lokeralexander-code/DAP_PCB/README.md

# DAP_PCB
The goal of this project is to create a digital audio player from scratch including a custom PCB, Mechanical Shell, and Software.

# PCB Progress:

The schematic is complete. Moving onto the layout and routing.
