lokeralexander-code/DAP_PCB/Electrical/Documentation/Power/LT3042 - +3V3 LDO/DAP_LT3042_Rev8.pdf

# Positive LDO (LT3042): Working Document

### Digital Audio Player • Rev 8

Author: Alexander Loker. Design decisions, component selection, analysis and verification. Drafted by: Claude (Anthropic). Structure and prose from the author’s direction and source data.

Contents

1 Summary | 1
2 Design Requirements | 1
3 Pin Configuration | 1
4 External Components | 2
5 Equations and Results | 2
6 Important Values | 3
7 Open Problems | 4
8 Revision Log | 4
9 Sources | 4

### 1. Summary

Field | Value
Manufacturer / MPN | Analog Devices, LT3042EDD#TRPBF
Package | 10-lead DFN, 3 × 3 mm, exposed pad (pin 11) = GND
Function | Ultralow-noise positive LDO, +3V9 → +3.3 V analog rail

### 2. Design Requirements

Requirement | Value
Input | +3V9 from LTC3440, 3.827 to 3.981 V; 7.7 mV pp ripple; ±90 mV load step (minimum 3.74 V)
Output | 3.32 V
Load | I/V, summing, OPA1622 (V+ side), DAC analog supplies
Maximum audio output | 0.6 V RMS (EW300: 119 dB/V worst nozzle, 28 Ω ±15%)
Output current | ≈ 35 mA quiescent (OPA1612 21.6 mA, OPA1622 5.2 mA, DAC analog 8 mA); ≈ 106 mA peak (200 mA rated)
Current limit | 125 mA programmed (RILIM)
UVLO | 3.5 V rising
Power good | ≈ 91% of VOUT, to MCU GPIO
Constraints | Low noise · Small footprint

### 3. Pin Configuration

Positive LDO (LT3042) · Rev 8 | Page 1 of 4

Pin | Name | Connection
1, 2 | IN | +3V9, CIN
3 | EN/UV | REN2 from IN, REN1 to GND
4 | PG | RPU to +3V3, MCU GPIO
5 | ILIM | RILIM to GND (Kelvin to pin 8)
6 | PGFB | RPG2 / RPG1 midpoint
7 | SET | RSET ∥ CSET to GND; CSET anode to SET
8 | GND | GND
9 | OUTS | OUT at the load
10 | OUT | +3V3A, COUT, RPG2
11 | Exposed pad | GND

### 4. External Components

Ref | Value / Rating | MPN | AL-PN
RSET | 33.2 kΩ 0.1% 0402 | YAGEO RT0402BRD0733K2L | #1-085
CSET | 2.2 µF ±20% tantalum, 16 V, 0603, polarized (no DC-bias derating, not piezoelectric) | Vishay 298D225X0016M2T | #1-098
CIN | 10 µF 10 V X7R 0805 (6.76 µF effective at 3.9 V) | Murata GCM21BR71A106KE22K | #1-081
COUT | 10 µF 10 V X7R 0805 (7.56 µF effective at 3.3 V) | Murata GCM21BR71A106KE22K | #1-081
REN1 | 50 kΩ 0.1% 0603 | YAGEO RT0603BRD0750KL | #1-075
REN2 | 90.9 kΩ 0.1% 0402 | YAGEO RT0402BRD0790K9L | #1-084
RPG1 | 100 kΩ 0.1% 0603 | YAGEO RT0603BRD07100KL | #1-066
RPG2 | 909 kΩ 1% 0402 | YAGEO RC0402FR-07909KL | #1-083
RILIM | 1.0 kΩ 0.1% 0402 | YAGEO RT0402BRD071KL
RPU | 10 kΩ 0603 | Generic

### 5. Equations and Results

Output voltage

VOUT = ISET RSET = 100 μA × 33.2 kΩ = 3.32 V

Source: LT3042 Datasheet (Analog Devices), (https://wcm-cce.cldnet.analog.com/media/en/technical-documentation/data-sheets/lt3042.pdf) SET pin. Undervoltage lockout (IEN term neglected)

VIN(UVLO) = 1.24 (1 + REN2

REN1 ) = 1.24 (1 + 90.9
50 ) = 3.494 V

Source: LT3042 Datasheet (Analog Devices), (https://wcm-cce.cldnet.analog.com/media/en/technical-documentation/data-sheets/lt3042.pdf) EN/UV pin.

Power-good threshold (IPGFB term neglected)

VOUT(PG) = 0.3 (1 + RPG2

RPG1 ) = 0.3 (1 + 909
100) = 3.027 V (91.2%)

Source: LT3042 Datasheet (Analog Devices), (https://wcm-cce.cldnet.analog.com/media/en/technical-documentation/data-sheets/lt3042.pdf) PGFB pin.
Current limit (ILIM threshold 300 mV; 125 mA·kΩ scale factor)

ILIM =

125 mA⋅kΩ

RILIM

=

125 mA⋅kΩ
1.0 kΩ = 125 mA (1.18 × the 106 mA peak)

Source: LT3042 Datasheet (Analog Devices), (https://wcm-cce.cldnet.analog.com/media/en/technical-documentation/data-sheets/lt3042.pdf) ILIM pin. SET noise-filter corner (1 µF effective)

fc =

1
2πRSETCSET

=

1
2π ⋅ 33.2 kΩ ⋅ 1 μF

= 4.8 Hz

Soft-start (fast start-up to ≈ 2.7 V, then the RSETCSET tail; 1 µF effective)

τ = RSETCSET = 33.2 ms, | t99 = τ ln 0.62
| 0.033

= 2.93 τ ≈ 97 ms/μF

Source: LT3042 Datasheet (Analog Devices), (https://wcm-cce.cldnet.analog.com/media/en/technical-documentation/data-sheets/lt3042.pdf) fast start-up. Headroom and maximum SPL

VIN(MIN) − VOUT = 3.74 − 3.32 = 0.42 V
SPLMAX = 119 + 20 log10(0.6) = 114.6 dB (116.6 dB steel nozzle)

CSET sweep (simulated; LTC3440 replaced by an ideal 3.9 V source; 29 Ω load):

CSET (effective) | t99 | Noise, 20 Hz to 20 kHz
0.47 µF | 46 ms | 1.16 µV RMS
1 µF | 98 ms | 0.63 µV RMS
2.2 µF | 214 ms | 0.40 µV RMS
4.7 µF | 455 ms | 0.34 µV RMS

Load current (0.6 V RMS = 0.85 V peak design maximum, both channels in phase):

Case | Per channel pk | Signal total | + Quiescent | Regulator pk
Full scale, 23.8 Ω (28 Ω −15%) | 35.7 mA | 71.3 mA | 35 mA | ≈ 106 mA
Full scale, 28 Ω nominal | 30.3 mA | 60.6 mA | 35 mA | ≈ 96 mA
110 dB SPL peak (0.35 V RMS), 23.8 Ω | 21.1 mA | 42.2 mA | 35 mA | ≈ 77 mA

### 6. Important Values

Item | Value
SET pin current | 100 µA
EN/UV rising threshold | 1.24 V
PGFB threshold | 300 mV
Dropout | 350 mV typ at 200 mA
Rated output current | 200 mA
Current limit | 125 mA programmed; ILIM also monitors output current (1:400, 0 to 300 mV)
Peak load | ≈ 106 mA at 0.6 V RMS maximum (53% of rating)
Minimum headroom | 0.42 V
UVLO / PG divider current | ≈ 28 µA from +3V9 / ≈ 3.3 µA from OUT
Output settled (99%) | ≈ 214 ms after enable (2.2 µF, simulated)
Output noise | 0.40 µV RMS, 20 Hz to 20 kHz (2.2 µF, simulated)
CSET leakage | 0.5 µA max at 16 V rating (≤ 0.5% output error); far lower at 3.3 V
Firmware delay | Wait ≈ 214 ms after enable before enabling the OPA1622
PG in shutdown | High impedance: reads good while EN/UV is low (simulated)

### 7. Open Problems

None.

### 8. Revision Log

Rev | Date | Change
0 | 2026-09-21 | Initial issue: RSET, UVLO, PG, soft-start, load current.
1 | 2026-09-22 | CSET 2.2 µF nominal; start-up and noise sweeps.
2 | 2026-09-22 | CIN / COUT 10 µF GCM21BR71A106KE22K.
3 | 2026-09-22 | Library parts assigned; RPG2 to 1%.
4 | 2026-09-22 | Maximum output 0.6 V RMS; peak load 98 mA.
5 | 2026-09-22 | Current limit 125 mA: RILIM 1.0 kΩ.
6 | 2026-09-23 | CSET 2.2 µF tantalum 298D225X0016M2T, anode to SET.
7 | 2026-09-25 | Reformatted; linked contents and sources; open problems closed.
8 | 2026-09-27 | Load updated from Power Budget Rev 6: quiescent ≈ 35 mA, peak ≈ 106 mA (current limit 1.18× the peak).

### 9. Sources

1. LT3042 Datasheet (Analog Devices) (https://wcm-cce.cldnet.analog.com/media/en/technical-documentation/data-sheets/lt3042.pdf)
