lokeralexander-code/DAP_PCB/Electrical/Documentation/Audio/OPA1612 - Summing Stage/DAP_Summing_Stage_OPA1612_Rev5.pdf

# Differential Summing Stage (OPA1612): Working Document

### Digital Audio Player • Rev 5

Author: Alexander Loker. Design decisions, component selection, analysis and verification.
Drafted by: Claude (Anthropic). Structure and prose from the author’s direction and source data.

Contents

1 Summary | 1
2 Design Requirements | 1
3 Pin Configuration | 2
4 External Components | 2
5 Equations and Results | 2
6 Open Problems | 3
7 Revision Log | 3
8 Sources | 4

### 1. Summary

Field | Value
Manufacturer / MPN | Texas Instruments, OPA1612AIDRGR (AL-PN #1-104)
Package | 8-SON, 3 × 3 mm, dual op-amp; one package covers both channels
Function | Differential summing with a second-order multiple-feedback (MFB) Butterworth low-pass
Signal chain | I/V (×2 per channel) → differential summing and MFB low-pass → OPA1622 output stage → 3.5 mm jack

Each channel’s two I/V outputs are subtracted into one single-ended signal, scaled to the headphone level, and low-pass filtered, all in one op-amp. MFB was chosen over Sallen-Key because it can attenuate (gain below 1), subtracts in the same stage, keeps rolling off into the MHz region where Sallen-Key feedthrough limits rejection to roughly 40 to 60 dB, and holds its inputs at a virtual ground, so there is no common-mode input swing on ±3.3 V rails. A Butterworth response gives the flattest passband with no ripple.

### 2. Design Requirements

Requirement | Value
Gain | 0.44: 0.85 V peak (0.6 V RMS) headphone target ÷ 1.93 V peak nominal differential input. The OPA1622 stage is unity gain.
Response | Butterworth, Q = 0.7071, passband ripple 0 dB
Corner frequency | f0 = 70 kHz (minimum 60.96 kHz for ≤ 0.05 dB loss at 20 kHz; margin for tolerance)
Passband loss | Chain total ≤ 0.1 dB at 20 kHz (I/V + summing)
Supply | ±3.3 V analog rails
Differential Summing Stage (OPA1612) · Rev 5 | Page 1 of 4

Requirement | Value
Constraints | Low noise (resistors in the hundreds of Ω) · Small footprint · C0G capacitors in the signal path

### 3. Pin Configuration

Channel A is left and channel B is right. Component labels follow the TI cookbook: R3 input, R1 feedback, R2 middle, C1 node-to-ground, C2 feedback.

Pin | Name | Connection
1 | OUT A | SUMM_L; R1 (220 Ω) back to node XL ; C2 (2.7 nF) back to −IN A
2 | −IN A | From IV_L via R3 (499 Ω) → node XL (C1 13 nF to GND) → R2 (681 Ω)
3 | +IN A | From IV_LB via the mirrored network: R3, node (C1 and R1 to GND), R2; C2 from +IN A to GND
4 | V− | −3V3, 0.1 µF X7R to GND
5 | +IN B | From IV_RB via the mirrored network
6 | −IN B | From IV_R via R3 → node XR (C1 to GND) → R2
7 | OUT B | SUMM_R; R1 back to node XR ; C2 back to −IN B
8 | V+ | +3V3_ANALOG, 0.1 µF X7R to GND

Polarity: the I/V stage inverts (IV_L = −k·s, IV_LB = +k·s), so the output is G × (k·s − (−k·s)) = +2Gk·s, in phase with the audio. This assumes DACL and DACR are the true-phase DAC outputs.

### 4. External Components

Ref | Value | Part / Notes | Qty | AL-PN
U | Dual op-amp | TI OPA1612AIDRGR, 8-SON | 1 | #1-104
R3 | 499 Ω, 0.1%, 0402 | YAGEO RT0402BRD07499RL, thin film. Same part as I/V Rf . | 4 | #1-105
R1 | 220 Ω, 0.1%, 0402 | YAGEO RT0402BRD07220RL, thin film. Feedback and mirrored ground leg. | 4 | #1-109
R2 | 681 Ω, 0.1%, 0402 | YAGEO RT0402BRD07681RL, thin film | 4 | #1-110
C1 | 13 nF, 50 V, C0G, 5%, 0805 | Murata GRM2195C1H133JA01D. One per X node; also filters common-mode. | 4 | #1-108
C2 | 2.7 nF, 50 V, C0G, 2%, 0402 | Murata GRM1555C1H272GE01D. Feedback and mirrored ground leg. | 4 | #1-107
Cdec | 0.1 µF X7R, 0402 | One per supply pin | 2

### 5. Equations and Results

Transfer function (TI labels)

H(s) =

1
R2R3C1C2

s

2 + s

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
) + 1 R1R2C1C2

Source: Analog Engineer’s Circuit Cookbook: Amplifiers, MFB Low-Pass Filter (Texas Instruments). (https://www.ti.com/seclit/eb/slyy137d/slyy137d.pdf)

Design equations (matching the denominator to s

2 + (ω0/Q) s + ω²
0

)

G = R1
R3

=

220
499 = 0.441

C1 =

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
) = 12.89 nF

C2 =

1
ω

2
0 R1R2C1

= 2.68 nF (ω0 = 2π ⋅ 70 kHz, Q = 0.7071, R2 = 681 Ω)

Source: Analog Engineer’s Circuit Cookbook: Amplifiers, MFB Low-Pass Filter (Texas Instruments); (https://www.ti.com/seclit/eb/slyy137d/slyy137d.pdf) derived from the transfer function above.

Passband loss (general second-order form, x = f/f0
)

|H|⁻² = (1 − x²
)

2

+ ( x
Q

)

2
, | Loss = 10 log10 |H|⁻²
Source: standard second-order low-pass magnitude; reduces to 1 + x⁴ | at Q = 0.7071.
Quantity (standard values 13 nF, 2.7 nF) | Value
f0 / Q | 69.4 kHz / 0.707
Summing-stage loss at 20 kHz | 0.030 dB
Chain loss at 20 kHz (with I/V 0.038 dB) | 0.068 dB
Attenuation at 1 MHz: summing stage / whole chain | ≈ 46 dB / ≈ 60 dB
Input: I/V peak per leg, nominal / worst | 0.96 V / 1.08 V
Input: differential peak, nominal / worst | 1.93 V / 2.17 V

### 5.1 Simulation

AC sweep of one channel with the TI OPA1612 model on ±3.3 V; differential drive of 0.5 V AC on each input, 180° apart; 10 Hz to 10 MHz, 100 points/decade. The I/V stage is not included.

Quantity | Simulated | Hand calculation
Passband gain | −7.1 dB | −7.1 dB (0.441)
−3 dB frequency | 69.30 kHz | 69.4 kHz
Passband shape | Flat through 20 kHz, no peaking | Q = 0.707
Stopband slope | 40 dB/decade | 40 dB/decade
Level at 1 MHz | −53 dB (46 dB below passband) | 46 dB below passband
High-frequency floor | Flattens near −84 dB at 5 to 10 MHz (op-amp gain-bandwidth limit) | Not modelled

### 6. Open Problems

None.

### 7. Revision Log

Rev | Date | Change
0 | 2026-09-24 | Initial issue: topology, requirements, component values, equations.
1 | 2026-09-24 | Standard values: R2 = 681 Ω, C1 = 13 nF, C2 = 2.7 nF.
2 | 2026-09-24 | AC-sweep simulation added.
3 | 2026-09-24 | Part numbers added; all resistors 0.1% thin film.
4 | 2026-09-24 | Leg assignment and output polarity recorded.
5 | 2026-09-25 | Reformatted; op-amp in title; requirements and constraints merged; equations typeset.

### 8. Sources

1. Analog Engineer’s Circuit Cookbook: Amplifiers, MFB Low-Pass Filter (Texas Instruments) (https://www.ti.com/seclit/eb/slyy137d/slyy137d.pdf)
2. OPA1612 Product Page and Datasheet (Texas Instruments) (https://www.ti.com/product/OPA1612)
3. ES9038Q2M Datasheet v1.4 (ESS Technology) (https://www.mouser.sk/datasheet/2/1082/ES9038Q2M_Datasheet_v1_4-3074379.pdf)
