lokeralexander-code/DAP_PCB/Electrical/Documentation/Power/LT3042 - +3V3 LDO/DAP_LT3093_Rev9.pdf

# Negative LDO (LT3093): Working Document

### Digital Audio Player • Rev 9

Author: Alexander Loker. Design decisions, component selection, analysis and verification. Drafted by: Claude (Anthropic). Structure and prose from the author’s direction and source data.

Contents

1 Summary | 1
2 Design Requirements | 1
3 Pin Configuration | 1
4 External Components | 2
5 Equations and Results | 2
6 Important Values | 4
7 Open Problems | 4
8 Revision Log | 4
9 Sources | 5

### 1. Summary

Field | Value
Manufacturer / MPN | Analog Devices, LT3093EDD#TRPBF
Package | 12-lead DFN, 3 × 3 mm, exposed pad (pin 13) = IN
Function | Ultralow-noise negative LDO, −3V9 → −3.3 V analog rail

### 2. Design Requirements

Requirement | Value
Input | −3V9 from the LT3462A inverter (regulated), −3.816 to −3.971 V
Output | −3.32 V
Load | I/V, summing, OPA1622 (V− side)
Maximum audio output | 0.6 V RMS (EW300: 119 dB/V worst nozzle, 28 Ω ±15%)
Output current | ≈ 27 mA quiescent; ≈ 98 mA peak (200 mA rated)
Current limit | 125 mA programmed (RILIM)
UVLO | −3.5 V rising
Power good | −3.0 V (90.4% of VOUT), to MCU GPIO
VIOC | Unused, floated
Constraints | Low noise · Small footprint

### 3. Pin Configuration

Negative LDO (LT3093) · Rev 9 | Page 1 of 5

Pin | Name | Connection
1, 2 | IN | −3V9, CIN
3 | EN/UV | REN2 from IN, REN1 to GND
4 | PG | RPU to +3V3, MCU GPIO
5 | PGFB | RPG1 / RPG2 midpoint
6 | ILIM | RILIM to GND (Kelvin to pin 9)
7 | VIOC | Not connected (float)
8 | SET | RSET ∥ CSET to GND; CSET cathode to SET (SET is at −3.32 V)
9 | GND | GND
10 | OUTS | OUT at the load
11, 12 | OUT | −3V3A, COUT, RPG1
13 | Exposed pad | IN (−3V9): own pour and via field, never GND

### 4. External Components

Ref | Value / Rating | MPN | AL-PN
RSET | 33.2 kΩ 0.1% 0402 | YAGEO RT0402BRD0733K2L | #1-085
CSET | 2.2 µF ±20% tantalum, 16 V, 0603, polarized; anode to GND | Vishay 298D225X0016M2T | #1-098
CIN | 10 µF 10 V X7R 0805 (6.76 µF effective at 3.9 V) | Murata GCM21BR71A106KE22K | #1-081
COUT | 10 µF 10 V X7R 0805 (7.56 µF effective at 3.3 V) | Murata GCM21BR71A106KE22K | #1-081
REN1 | 50 kΩ 0.1% 0603 | YAGEO RT0603BRD0750KL | #1-075
REN2 | 88.7 kΩ 0.1% 0402 | YAGEO RT0402BRD0788K7L
RPG1 | 135 kΩ 0.1% 0402 (E192) | YAGEO RT0402BRD07135KL
RPG2 | 15 kΩ 0.1% 0402 | YAGEO RT0402BRD0715KL | #1-078
RILIM | 15.6 kΩ 0.1% 0402 (E192) | YAGEO RT0402BRD0715K6L
RPU | 10 kΩ 0603 | Generic

### 5. Equations and Results

Output voltage (range over ISET = 98 to 102 µA)

VOUT = −ISET RSET = −100 μA × 33.2 kΩ = −3.32 V (−3.254 to − 3.386 V)

Source: LT3093 Datasheet (Analog Devices), (https://www.analog.com/media/en/technical-documentation/data-sheets/lt3093.pdf) SET pin.

Undervoltage lockout (IEN negligible for REN1 < 100 kΩ)

REN2 = REN1 (

3.5
1.26 − 1) = 88.89 kΩ → 88.7 kΩ

VIN(UVLO) = −1.26 (1 + 88.7
50 ) = −3.495 V (−3.33 to − 3.69 V)

VIN(UVLO,falling) = −(1.26 − 0.215) (1 + 88.7 50 ) = −2.90 V (sim ≈ −3.0 V)

Source: LT3093 Datasheet (Analog Devices), (https://www.analog.com/media/en/technical-documentation/data-sheets/lt3093.pdf) EN/UV pin. Power-good threshold (RPG1 is the top resistor)

RPG1 = RPG2 (

3.0

0.3 − 1) = 135 kΩ, VOUT(PG) = −0.3 (1 + 135 15 ) = −3.000 V (90.4%)

Source: LT3093 Datasheet (Analog Devices), (https://www.analog.com/media/en/technical-documentation/data-sheets/lt3093.pdf) PGFB pin.
Current limit (ILIM regulates to −300 mV; 1.95 kΩ·A scale factor)

ILIM =

1.95 kΩ⋅A

RILIM

=

1.95 kΩ⋅A
15.6 kΩ = 125 mA

Source: LT3093 Datasheet (Analog Devices), (https://www.analog.com/media/en/technical-documentation/data-sheets/lt3093.pdf) ILIM pin. Soft-start (fast start-up to −3.0 V, then the RSETCSET tail)

t99 − tPG = τ ln 0.32
0.033

= 2.27 τ ≈ 75 ms/μF (2.2 μF ∶ 166 ms)

Source: LT3093 Datasheet (Analog Devices), (https://www.analog.com/media/en/technical-documentation/data-sheets/lt3093.pdf) fast start-up.
Headroom (maximum dropout 280 mV at 100 mA) and dissipation

|VIN(MIN)

| − |VOUT(MIN)

| − VDO(MAX) = 3.816 − 3.287 − 0.28 = 0.25 V
PD = 0.098 × (3.981 − 3.32) + 0.004 × 3.981 ≈ 0.08 W, ΔTJ ≈ 0.08 × 34 ≈ 2.8 ∘C

Source: LT3093 Datasheet (Analog Devices), (https://www.analog.com/media/en/technical-documentation/data-sheets/lt3093.pdf) dropout and θJA.
Load current (0.6 V RMS = 0.85 V peak design maximum, both channels in phase):
Case | Per channel pk | Signal total | + Quiescent | Regulator pk
Full scale, 23.8 Ω (28 Ω −15%) | 35.7 mA | 71.3 mA | 27 mA | ≈ 98 mA
Full scale, 28 Ω nominal | 30.3 mA | 60.6 mA | 27 mA | ≈ 88 mA
110 dB SPL peak (0.35 V RMS), 23.8 Ω | 21.1 mA | 42.2 mA | 27 mA | ≈ 69 mA

### 5.1 Simulation Results

Test | Result
Dropout (29 Ω / 16.5 Ω load) | 203 mV at ≈ 115 mA; 214 mV at ≈ 201 mA

Test | Result
Noise vs CSET (0.47 / 1 / 2.2 / 4.7 µF) | 1.44 / 0.75 / 0.44 / 0.34 µV RMS (20 Hz to 20 kHz)
Output impedance | 0.26 mΩ at 1 kHz; 5.2 mΩ at 20 kHz; 76 mΩ peak at 282 kHz
Start-up (0 → −3.9 V in 20 ms) | Regulates at −3.62 V input; PG at −3.000 V after 3.9 ms; settled 166 ms after PG
Brownout (−3.9 → 0 V in 50 ms) | Loses regulation at −3.490 V; PG low at −3.129 V; off at −2.957 V
Load step 27 ↔ 205 mA, 1 µs edges | −7.6 / +3.6 mV, ≈ 2 cycles at 140 kHz, settles in ≈ 20 µs
Line step −3.9 → −3.74 V | 61 µV peak, settles in ≈ 20 µs (≈ 68 dB)
Input ripple 7.7 mV pp at 1.2 MHz | 1.67 µV pp at OUT

### 6. Important Values

Item | Value
SET pin current | 100 µA (98 to 102 µA over temperature)
EN/UV threshold | −1.26 V (−1.20 to −1.33 V), 215 mV hysteresis
PGFB threshold | −300 mV (288 to 312 mV), 7 mV hysteresis
Dropout | 214 mV sim / 330 mV max at 200 mA
Peak load | ≈ 98 mA at 0.6 V RMS maximum (49% of rating)
Current limit | 125 mA programmed; internal backup 400 mA typ, 220 mA min
GND pin current | 2.35 mA quiescent; ≈ 7 mA at 200 mA (in dropout)
PSRR at 1.2 MHz | −77.9 dB (simulated)
Output noise | 0.44 µV RMS at 2.2 µF, 20 Hz to 20 kHz (simulated; model ≈ 15% optimistic)
Firmware delay | Wait ≥ 170 ms after PG before enabling the OPA1622
PG at cold start | Reads high until IN passes ≈ −1.8 V; ignore PG until +3V3 is up
PG in shutdown | Pulled low: reads not-good (opposite of the LT3042)
COUT requirement | ≥ 4.7 µF, ESR < 30 mΩ, ESL < 1.5 nH
θJA (DFN) | 34 °C/W

### 7. Open Problems

# | Problem

1 | Exposed pad is IN (−3V9): dedicated pour and via field; the footprint must not tie it to GND.
2 | DAC analog supply allocation to this rail.
3 | Confirm package (DFN vs MSOP-12E) and the REN2 / RPG1 part numbers.
4 | PG brownout warning is 2.2 ms at the simulated ramp rate; a real brownout is faster. Consider a hardware mute from PG.
5 | PG low is specified at 100 µA; a 10 kΩ pull-up to +3V3 sinks 330 µA. Verify or raise RPU.
6 | ILIM scale-factor tolerance: confirm the minimum limit stays above 98 mA; confirm the RILIM part number.
7 | Remaining simulations: current limit at 125 mA, PG in shutdown, full chain with the LT3462A.

### 8. Revision Log

Rev | Date | Change
0 | 2026-09-22 | Initial issue: RSET, UVLO, PG, soft-start, headroom, dissipation.
1 | 2026-09-22 | PG divider 135 kΩ / 15 kΩ, threshold −3.0 V.
2 to 4 | 2026-09-22 | Simulation results: dropout, PSRR, noise, output impedance, start-up, brownout, load and line steps.
5 | 2026-09-22 | Maximum output 0.6 V RMS; peak load 98 mA.
6 | 2026-09-22 | Current limit 125 mA: RILIM 15.6 kΩ.
7 | 2026-09-23 | Input from the LT3462A inverter.
8 | 2026-09-23 | CSET 2.2 µF tantalum, cathode to SET.
9 | 2026-09-25 | Reformatted; linked contents and sources; quiescent and 2.7 MHz PSRR items removed.

### 9. Sources

1. LT3093 Datasheet (Analog Devices) (https://www.analog.com/media/en/technical-documentation/data-sheets/lt3093.pdf)
