lokeralexander-code/DAP_PCB/Electrical/Documentation/Audio/OPA1622 - Headphone Output/DAP_Output_Stage_Rev1.pdf

# DAP Output Stage Rev1

Sep 25, 2026 · @Alex

## Attribution

Author: Alexander Loker, responsible for design decisions, component selection, analysis, and verification
Drafter/documenter: Claude, writing from Alexander's direction and source data

## PartIdentification

The output stage drives the headphones from the summing-stage outputs. Each channel is a unity-gain non-inverting follower with output-inclusive compensation.
Signal chain per channel: I/V (×2) → differential summing + MFB low-pass → OPA1622 follower → 3.5 mm jack.
Amplifier: TI OPA1622IDRCR, dual, 10-pin VSON (DRC)
Jack: Same Sky SJ1-3535NS, 3.5 mm stereo TRS, right angle, through hole, shielded, tip and ring switches
ESD: TI ESD122DMXR, 2-channel bidirectional, on tip and ring

## Design Requirements

Gain: 1. The summing stage already sets 0.85 V peak (0.6 V RMS) and in-phase polarity. Load: Simgot EW300, 28 Ω ±15% (23.8 Ω worst case); ≈ 36 mA peak per channel at 0.85 V peak.
Output impedance: < 1 Ω, 20 Hz to 20 kHz.
Coupling: DC coupled.
Stability: stable into cable capacitance.
No additional low-pass. The I/V pole and MFB filter already provide ≈ 60 dB at 1 MHz; another filter would add passband loss, raise output impedance, and complicate stability.

DAP Output Stage Rev0

## Design Constraints

±3.3 V supply rails
Low noise
Small footprint
C0G capacitors in the signal path

## Topology Rationale

Non-inverting follower over inverting stage: keeps polarity, draws essentially no current from the MFB output, and applies the full loop gain as feedback for the lowest output impedance.
Output-inclusive compensation: a small isolation resistor R_iso separates the op-amp from cable capacitance. Audio-frequency feedback (R_fb) is taken after R_iso, at the jack, so the loop corrects R_iso's drop. High-frequency feedback (C_f) is taken before R_iso, so the loop does not see the capacitive load.

## Pin Connections

OPA1622IDRCR

Pin | Name | Connection
1 | +INA | SUMM_R
10 | −INA | R_fb (to ring node) and C_f (to OUTA)
9 | OUTA | R_iso → ring node (RIGHT_EAR)
5 | +INB | SUMM_L
6 | −INB | R_fb (to tip node) and C_f (to OUTB)
7 | OUTB | R_iso → tip node (LEFT_EAR)
2 | V+ | +3V3_ANALOG, 0.1 µF + 1 µF to GND
4 | V− | −3V3, 0.1 µF + 1 µF to GND
3 | GND | GND (reference for EN)
8 | EN | EN network (see below)

SJ1-3535NS

## Component Values

Pin | Name | Connection
Pad | Thermal pad | V− (−3.3 V), own pour and via field
Pin | Function | Connection
1 | Sleeve | GND
2 | Tip | Left output node (TIP), ESD122 IO2, 10 kΩ bleed to GND
3 | Ring | Right output node (RING), ESD122 IO1
4 | Tip switch (normally closed to tip, opens on insertion) | Detect node: 100 kΩ pull-up to +3V3_DIG, 10 kΩ series to PLUG_DET (GPIO)
5 | Ring switch | Not connected
SH1– SH3 | Shield | GND
Ref | Value | Qty | Notes
R_iso | 4.7 Ω | 2 | Op-amp output → jack node
R_fb | 499 Ω, 0.1% (YAGEO RT0402BRD07499RL) | 2 | Jack node → −IN; same part as I/V R_f
C_f | 1.5 nF C0G, 1% (Murata GCM1885C1H152FA16D) | 2 | Op-amp output → −IN; same part as I/V C_f
Rail decoupling | 0.1 µF X7R + 1 µF X5R per rail | 4 | V+ and V−
EN series | 54.9 kΩ | 1 | EN_SPEAKER → EN
EN pull-down | 50 kΩ | 1 | Holds EN low at boot

## Enable (EN)

Logic threshold 0.82 V, referenced to the GND pin.
V_EN = 3.3 V × 50k / (54.9k + 50k) ≈ 1.57 V from a 3.3 V GPIO.
Ramp time constant (54.9k ∥ 50k) × 0.1 µF ≈ 2.6 ms.
GPIO control is used instead of the datasheet's supply-derived divider (Figure 48) so firmware can mute on demand. Firmware enables the amp only after both analog rails are up, and keeps it disabled while unplugged.

## Plug Detect

The GPIO draws no current, so the 10 kΩ series resistor does not shift the reading.

## Equations and Results

Feedback handover: f_x = 1 / (2π × R_fb × C_f) = 1 / (2π × 499 Ω × 1.5 nF) ≈ 213 kHz

Ref | Value | Qty | Notes
EN ramp | 0.1 µF X7R | 1 | EN node → GND
Detect pull-up | 100 kΩ to +3V3_DIG | 1 | On the jack-side detect node
Detect series | 10 kΩ | 1 | Detect node → PLUG_DET (GPIO); limits current when the tip swings negative
Tip bleed | 10 kΩ | 1 | TIP → GND; holds the tip near 0 V when the amp is disabled
ESD | ESD122DMXR | 1 | Tip and ring, at the jack
State | Detect node / GPIO | Reads
Unplugged, amp off (tip held by bleed) | 3.3 V × 10k / 110k ≈ 0.3 V | Low
Unplugged, amp on (tip ≈ 0 V) | ≈ 0 V | Low
Plugged (switch open) | 3.3 V | High

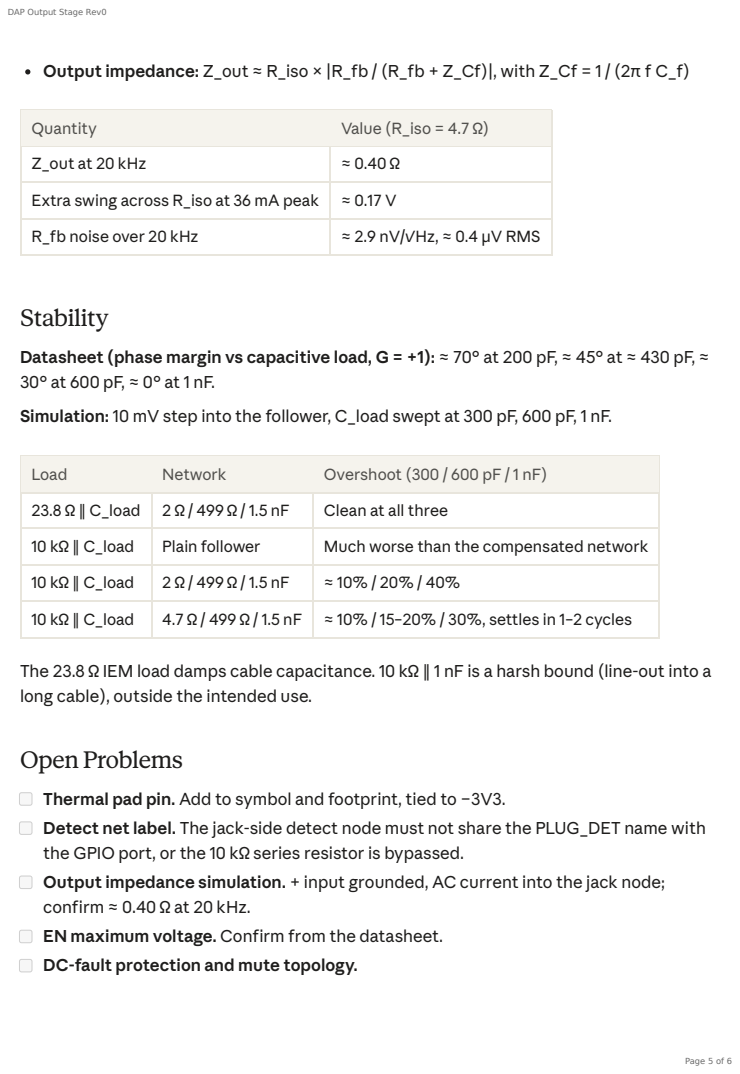
[picture p6: page 5]
Stability; Open Problems

Output impedance: Z_out ≈ R_iso × |R_fb / (R_fb + Z_Cf)|, with Z_Cf = 1 / (2π f C_f)

Quantity | Value (R_iso = 4.7 Ω)
Z_out at 20 kHz | ≈ 0.40 Ω
Extra swing across R_iso at 36 mA peak | ≈ 0.17 V
R_fb noise over 20 kHz | ≈ 2.9 nV/√Hz, ≈ 0.4 µV RMS

Datasheet (phase margin vs capacitive load, G = +1): ≈ 70° at 200 pF, ≈ 45° at ≈ 430 pF, ≈
Simulation: 10 mV step into the follower, C_load swept at 300 pF, 600 pF, 1 nF.

Load | Network | Overshoot (300 / 600 pF / 1 nF)
23.8 Ω ∥ C_load | 2 Ω / 499 Ω / 1.5 nF | Clean at all three
10 kΩ ∥ C_load | Plain follower | Much worse than the compensated network
10 kΩ ∥ C_load | 2 Ω / 499 Ω / 1.5 nF | ≈ 10% / 20% / 40%
10 kΩ ∥ C_load | 4.7 Ω / 499 Ω / 1.5 nF | ≈ 10% / 15–20% / 30%, settles in 1–2 cycles

The 23.8 Ω IEM load damps cable capacitance. 10 kΩ ∥ 1 nF is a harsh bound (line-out into a
long cable), outside the intended use.

Thermal pad pin. Add to symbol and footprint, tied to −3V3.
Detect net label. The jack-side detect node must not share the PLUG_DET name with
the GPIO port, or the 10 kΩ series resistor is bypassed.
Output impedance simulation. + input grounded, AC current into the jack node;
confirm ≈ 0.40 Ω at 20 kHz.
EN maximum voltage. Confirm from the datasheet.
DC-fault protection and mute topology.

## Rev Log

## Sources

OPA1622 datasheet (TI): phase margin vs capacitive load; output transients during power up and power down
SJ1-3535NS datasheet (Same Sky)
ESD122 product page, TI (https://www.ti.com/product/ESD122)
Rev | Date | Change
1 | 2026-09-25 | R_iso placed. Plug detect finalized: 100 kΩ jack-side pull-up, 10 kΩ series to GPIO, 10 kΩ tip bleed; Plug Detect section added. R_iso and plug-detect open problems closed; detect net label issue added.
0 | 2026-09-25 | Initial release. Topology, pin connections, component values, EN network, equations, stability data, open problems.
