lokeralexander-code/DAP_PCB/Electrical/Documentation/Audio/OPA1612 - Current to Voltage/DAP_IV_Stage_Rev7.pdf

# DAP I/V Stage Rev7

Sep 24, 2026 · @Alex

## Attribution

Author: Alexander Loker, responsible for design decisions, component selection, analysis, and verification
Drafter/documenter: Claude, writing from Alexander's direction and source data

## PartIdentification

Four I/V (current-to-voltage) channels convert the ES9038Q2M's differential current outputs (DACL, DACLB, DACR, DACRB) to voltages.
Signal chain per channel: I/V (×2) → differential summing + MFB low-pass → OPA1622 → headphone jack.
Op-amp: OPA1612AIDRGR (TI, dual, 8-SON 3 × 3 mm). Two packages cover the four I/V channels.

## Design Requirements

DAC output mode: current mode. ESS specifies its headline figures (128 dB DNR, −120 dB THD+N) in differential current mode (p. 52).
Maximum headphone output: 0.6 V RMS (0.85 V peak).
Gain structure: run the I/V stage as hot as the rails allow, and attenuate toward 0.6 V RMS later in the chain.
Op-amp distortion: below the DAC's so the DAC stays the limit.

## Design Constraints

±3.3 V supply rails (6.6 V total)
Low noise
Small footprint

DAP I/V Stage Rev0

## DAC Output Data (ES9038Q2M, p. 52)

## I/V Operating Point

V_G = 0 V (op-amp + input to GND). R_f = 500 Ω. Worst case uses R_DAC = 689 Ω (774 Ω − 11%). Output swing limit ≈ ±2.7 V (within 600 mV of ±3.3 V rails).

With V_G = 0 V, the DC current flows through R_f and shifts the I/V output’s idle point below 0 V. It is common to both legs of a channel and cancels in the differential summing stage.
Feedback capacitor: C_f = 1.5 nF, C0G ceramic, in parallel with R_f. Target ≤ 0.05 dB loss at 20 kHz from the I/V stage alone.
Parameter | Value
Output impedance R_DAC | 774 Ω ±11%
Voltage-mode range V_OPP | 0.906 × AVCC = 2.99 V p-p at AVCC = 3.3 V
Voltage-mode offset V_OCM | AVCC/2 = 1.65 V
Full-scale current per pin | V_OPP / R_DAC = 3.863 mA p-p
Current-mode offset | (V_OCM − V_G) / R_DAC
Quantity | Nominal (R_DAC = 774 Ω) | Worst case (R_DAC = 689 Ω)
DC current per pin, 1.65 V / R_DAC | 2.13 mA | 2.39 mA
Audio peak current per pin | 1.93 mA | 2.17 mA
Max R_f, 2.7 V / (I_DC + I_AC,pk) | 665 Ω | 592 Ω
Quantity | Value
I/V corner f_c = 1 / (2π R_f C_f) | ≈ 212 kHz
Loss at 20 kHz, 10 log₁₀(1 + (20 kHz / f_c)²) | ≈ 0.038 dB

## Equations

V_{out} = -I \cdot R_f \qquad f_c = \frac{1}{2\pi R_f C_f} \qquad dB = 20\log_{10}\left(\frac{V_1}{V_2}\right)

## Open Problems

## Rev Log

Linearity at ±3.3 V. Confirm THD on the prototype.

Rev | Date | Change
7 | 2026-09-24 | C_f = 1.5 nF C0G selected (f_c ≈ 212 kHz, ≈ 0.038 dB loss at 20 kHz). C_f open problem closed.
6 | 2026-09-24 | V_G = 0 V and R_f = 500 Ω selected. I/V Operating Point section added. DC offset and R_f open problems closed.
5 | 2026-09-24 | OPA1692, OPA4134, and SSM2135 source links removed.
4 | 2026-09-24 | LTspice model no longer required: constraint and model-check open problem removed.
3 | 2026-09-24 | Op-amp recorded in Part Identification: OPA1612AIDRGR (8-SON). Package open problem closed.
2 | 2026-09-24 | Op-amp candidates section removed.
1 | 2026-09-24 | OPA1612 selected for the I/V stage. OPA1692 kept as evaluated alternative; OPA4134 rejected. Open problems updated.
0 | 2026-09-24 | Initial release. Signal chain, DAC output data, candidate evaluation, open problems.

ES9038Q2M Datasheet v1.4 (ESS), p. 52 (project file)
