lokeralexander-code/DAP_PCB/Electrical/Documentation/Power/LTC3440 - Buck(s)/DAP_LTC3440_Rev4.pdf

# Buck-Boost (LTC3440) — Working Document

### Digital Audio Player · Rev 4

Author: Alexander Loker — design decisions, component selection, analysis and verification. Drafted by: Claude (Anthropic) — structure and prose from the author’s direction and source data.

## 1. Part Identification

Field | Value

Manufacturer / MPN Analog Devices — LTC3440EMS#TRPBF
Package | 10-lead MSOP (MS)
Function | Synchronous buck-boost, SYS → 3.9 V intermediate rail

## 2. Design Requirements

Requirement | Value
Input | SYS, 3.0 – 4.2 V
Output | 3.9 V
Load | Analog chain only (LT3042 +3.3 V; LT3462A inverter → LT3093 −3.3 V)
Output current | ≈ 249 mA peak (98 mA LT3042 + 151 mA LT3462A input at 65%); 250
| mA design
Fault ceiling | ≈ 0.3 A (LT3042 125 mA + LT3462A at its switch limit)
Switching frequency | 1.2 MHz, fixed (Burst Mode off)
Output ripple target | 0.5% (19.5 mV pp)
Soft-start | Output up by ≈ 6 ms, MCU-enabled
Source resistance | ≈ 0.21 Ω

Constraints: Low noise · Small footprint

## 3. Pin Configuration

Pin Name | Connection
1 | RT | R_T to GND
2 | MODE/SYNC | GND
3 | SW1 | L
4 | SW2 | L
5 | GND | GND
6 | VOUT | +3V9, C_OUT, R1
7 | VIN | SYS, C_IN
8 | SHDN/SS | R_SS from GPIO, C_SS to GND
9 | FB | R1 / R2 midpoint
10 | VC | C_P1 + R_Z to FB

## 4. External Components

Ref | Value

Rating /
package | MPN | AL-PN
L | 6.8 µH ±20% | I_sat 3.5 A
(20%), 74.1
mΩ
Bourns SRP4030FA-6R8M | #1-076
C_IN | 4.7 µF | 16 V X7R 0805 | Murata GRM21BR71C475KE51L | #1-071
C_OUT | 22 µF | 25 V X7S 1210 | Murata GCM32EC71E226KE36L | #1-073
R1 | 220 kΩ 0.1% | 0402 | YAGEO RC0402BR-07220KL | #1-074
R2 | 100 kΩ 0.1% | 0603 | YAGEO RT0603BRD07100KL | #1-066
R_T | 50 kΩ 0.1% | 0603 | YAGEO RT0603BRD0750KL | #1-075
R_Z | 15 kΩ 0.1% | 0402 | YAGEO RT0402BRD0715KL | #1-078
C_P1 | 1.5 nF ±2% | 50 V C0G 0402 | Murata GRM1555C1H152GA01D | #1-077
R_SS | 54.9 kΩ 0.1% | 0402 | YAGEO RT0402BRD0754K9L | #1-079
C_SS | 0.1 µF | 50 V X7R 0402 | Murata GCM155R71H104KE02D | #1-080
R_PD | 1 MΩ | GPIO side of
| | R_SS | — | —

## 5. Equations and Results

Switching frequency

RT =

6 × 10¹⁰
f

=

6 × 10¹⁰
1.2 × 10⁶

= 50 kΩ

Output voltage

### VOUT = 1.22 (1 + R1

R2

) = 1.22 (1 + 220
100) = 3.904 V (3.827 − 3.981 V )

Inductor ripple (f in MHz; 250 mA design current)

### Rippleboost =

VIN(MIN)(VOUT − VIN(MIN))

f IOUT L VOUT

=

3.0 × 0.9
1.2 × 0.25 × 6.8 × 3.9

### = 0.34 (85 mApp)

### Ripplebuck =

VOUT (VIN(MAX) − VOUT )

f IOUT L VIN(MAX)

### = 0.14 (34 mApp)

Peak inductor current (3.0 V in, η ≈ 0.85)

IL,pk =

0.25 × 3.9
3.0 × 0.85

+

0.085
2

= 0.42 A

Output capacitance (0.5% ripple)

COUT ≥

IOUT (VOUT − VIN(MIN)) ⋅ 100

### %Ripple ⋅ V ²

OUT ⋅ f | =

0.25 × 0.9 × 100
0.5 × 3.9² × 1.2 × 10⁶

= 2.47 μF

Soft-start

### τ = RSSCSS = 5.49 ms, tx = τ ln

VGPIO

VGPIO − Vx

Enable (1.0 V): 2.0 ms · Ramp complete (2.2 V): 6.0 ms

Four-switch region

### VIN = VOUT (1 − 150 ns ⋅ f) to

VOUT

### 1 − 150 ns ⋅ f = 3.20 to 4.76 V

Load (0.6 V RMS max output; LDO limits 125 mA each)

Case | LT3042 | LT3462A input (η 65%) LTC3440 load
Quiescent | 27 mA | ≈ 42 mA | ≈ 69 mA
Full scale, 23.8 Ω | 98 mA | ≈ 151 mA | ≈ 249 mA
Fault (LDOs / inverter in limit) 125 mA | ≈ 0.18 A | ≈ 0.3 A

## 6. Important Values

Item | Value
Switch current limit | 2.7 A typ (2.5 – 2.9 A)
Simulated output ripple | 7.7 mV pp (target 19.5 mV)
Load step | 150 ↔ 250 mA ±90 mV, no ringing, 0.3 ms recovery (conservative
| vs 196 mA peak)
Loop crossover (implied) | ≈ 8 kHz
Minimum rail during step | 3.74 V

ESL spikes (0.5 nH, sim) ≈ 0.3 V — layout item
Peak load | ≈ 249 mA (at design current)
Fault ceiling | ≈ 0.3 A — inductor peak ≈ 0.5 A vs 3.5 A I_sat, switch 2.5 A min

## 7. Open Problems

# | Problem

1 | LT3462A efficiency assumed 65% — peak load sits at the 250 mA design current; confirm in LTspice and re-check ripple and load step

## 8. Revision Log

Rev | Date | Change
0 | 2026-09-21 Initial design, calculations and simulation.
1 | 2026-09-21 Schematic captured; VC-to-FB short corrected; MPN to #TRPBF.
2 | 2026-09-21 Condensed to essentials.
3 | 2026-09-22 Load updated to 0.6 V RMS max output (≈ 196 mA peak) and 250 mA
| | fault ceiling from 125 mA LDO current limits.
4 | 2026-09-23 Negative branch now LT3462A inverter: peak load ≈ 249 mA, fault ≈
| | 0.3 A.
