lokeralexander-code/DAP_PCB/Electrical/Documentation/Audio/ES9038Q2M - DAC/DAP_ES9038Q2M_Clocking_Rev9.pdf

# DAC Clocking and I2S Interface (ES9038Q2M): Working Document

### Digital Audio Player • Rev 9

Author: Alexander Loker. Design decisions, component selection, analysis and verification.
Drafted by: Claude (Anthropic). Structure and prose from the author’s direction and source data.

Contents

1 Summary | 1
2 Design Requirements | 1
3 Pin Configuration | 1
4 External Components | 3
5 Equations and Results | 3
6 Important Values | 4
7 Open Problems | 4
8 Revision Log | 4
9 Sources | 5

### 1. Summary

Field | Value
Manufacturer / MPN | ESS Technology, ES9038Q2M
Package | 30-lead QFN with exposed pad (exposed pad = DGND)
Function | 32-bit stereo audio DAC, differential current outputs
Timing role | I2S master. The ESP32-S3 is I2S slave.
Clock sources | Two tri-state oscillators on XI: 22.5792 MHz (44.1 kHz family) and 24.576 MHz (48 kHz family)

The DAC is the I2S timing master so that its DPLL can be turned off (synchronous mode). In this mode every audio clock, including the DAC’s internal MCLK, BCLK and LRCLK, is derived from one local low-noise oscillator, which gives the best audio performance. The ESP32-S3 only supplies PCM data.

### 2. Design Requirements

Requirement | Value
Input format | PCM over I2S. No DSD, no S/PDIF.
Sample rates | 44.1 kHz family: 44.1, 88.2, 176.4 kHz. 48 kHz family: 48, 96, 192 kHz.
Timing roles | DAC master (Reg 10 master_mode = 1), ESP32-S3 slave
DPLL | Off, synchronous mode (Reg 10 128fs_mode = 1): MCLK = 128 × FSR exactly
Clocking | Two external tri-state oscillators on XI, one per family, one enabled at a time
XI frequency | ≤ 100 MHz. Chosen for lowest phase noise.
DAC Clocking and I2S Interface (ES9038Q2M) · Rev 9 | Page 1 of 5

Requirement | Value
Maximum sample rate | 176.4 / 192 kHz, fixed by the selected oscillators. 352.8 / 384 kHz would need 45.1584 and 49.152 MHz oscillators.
I2C speed | 100 kHz standard mode (SCL < MCLK / 20)
Clock switching | Only while the DAC is muted or RESETB is low
Constraints | Low noise · Small footprint

### 3. Pin Configuration

Pin | Name | Connection
1 | AVCC_R | +3V3_ANALOG, 0.1 µF + 1 µF to GND
2 | DACRB | Right negative current output, to I/V stage
3 | DACR | Right positive current output, to I/V stage
4 | BIAS | Not connected
5 | SW | Not connected
6 | FSYNC | Not connected
7 | HPSDb | Not connected
8 | DACL | Left positive current output, to I/V stage
9 | DACLB | Left negative current output, to I/V stage
10 | AVCC_L | +3V3_ANALOG, 0.1 µF + 1 µF to GND
11 | AGND_L | GND
12 | VCCA | +3V3_ANALOG, 0.1 µF + 1 µF to GND
13 | DVCC | +3V3_DIG, 0.1 µF to GND
14 | DGND | GND
15 | DVDD | 4.7 µF to GND only (internal 1.2 V core regulator output)
16 | GPIO2 | ESP32-S3 GPIO, 10 kΩ pull-down (see 3.1)
17 | GPIO1 | ESP32-S3 GPIO, 10 kΩ pull-down (see 3.1)
18 | DATA2 | PCM data input from ESP32-S3
19 | DATA1 | LRCLK output to ESP32-S3
20 | DATA_CLK | BCLK output to ESP32-S3
21 | RESETB | ESP32-S3 GPIO, 10 kΩ pull-down
22 | RT1 | GND (reserved, must connect to DGND)
23 | SCL | ESP32-S3, 10 kΩ pull-up to +3V3_DIG
24 | SDA | ESP32-S3, 10 kΩ pull-up to +3V3_DIG
25 | ADDR | 10 kΩ pull-up to +3V3_DIG (I2C address 0x92)
26 | NC | Not connected
27 | VCCA | +3V3_ANALOG, 0.1 µF + 1 µF to GND
28 | XOUT | Not connected (XI driven by an oscillator)
29 | XI | Oscillator outputs, each through a 22 Ω series resistor
30 | AGND_R | GND
EP | Exposed pad | DGND (GND)

Source: ES9038Q2M Datasheet v1.4 (ESS Technology), (https://www.mouser.sk/datasheet/2/1082/ES9038Q2M_Datasheet_v1_4-3074379.pdf) pp. 4 to 5 (pin descriptions); p. 14 (I2C address).

DAC Clocking and I2S Interface (ES9038Q2M) · Rev 9 | Page 2 of 5

### 3.1 GPIO1 and GPIO2 Functions

Each GPIO is set independently in Register 8 (gpio1_cfg bits 3:0, gpio2_cfg bits 7:4). The default is mode 13, an input that shuts the DAC down when pulled high, so both pins carry 10 kΩ pull-downs to keep the DAC running before firmware configures them.

Mode | Name | Direction | Behaviour
0 | Automute Status | Output | High when automute is triggered
1 | Lock Status | Output | High when the DAC is locked to its clocks
2 | Volume Min | Output | High when all volume controls have ramped to minus full scale
3 | CLK | Output | Buffered MCLK for synchronising other devices
4 | Automute/Lock Interrupt | Output | High when lock or automute status changes; cleared by reading Register 64
5 | Amplifier_PDB | Output | Follows Register 39 bit 6
6 | Charge Pump Clock | Output | Clock divided from MCLK (Registers 30 to 31)
7 | ADC Data | Input | Enables the calibration function
8 | Standard Input | Input | High impedance; level read back through Register 65
9 | Input Select | Input | Toggles the input selection (Register 21)
10 | Mute All | Input | Logic high forces a mute; low gives normal operation
13 | Analog Input Shutdown (default) | Input | Logic high shuts the DAC down
14 | Soft Start Complete | Output | High when the DAC output has ramped to ground
15 | Output 1 | Output | Forced high

Source: ES9038Q2M Datasheet v1.4 (ESS Technology), (https://www.mouser.sk/datasheet/2/1082/ES9038Q2M_Datasheet_v1_4-3074379.pdf) p. 22 (Register 8). Modes 11 and 12 are reserved.

### 4. External Components

Ref | Value | Part / Notes | AL-PN
X1 | 22.5792 MHz | ECS-2520MVLC-225.792-CN-TR, XO, ±25 ppm, 2.5 × 2.0 mm, tri-state OE | #1-100
X2 | 24.576 MHz | Abracon ASTX-H11-24.576MHZ-T, TCXO, ±2.5 ppm, 3.2 × 2.5 mm, tri-state OE | #1-101
RS1, RS2 | 22 Ω, 1%, 0402 | YAGEO RC0402FR-0722RL. At each oscillator output; outputs join at XI. | #1-102
REN1, REN2 | 10 kΩ | OE pull-downs. Both oscillators off until firmware enables one.
RRST | 10 kΩ | RESETB pull-down. DAC held in reset until firmware releases it.
RGPIO1, RGPIO2 | 10 kΩ | GPIO pull-downs (default mode 13 must stay low)
RSCL, RSDA, RADDR | 10 kΩ | Pull-ups to +3V3_DIG
CDVDD | 4.7 µF, 6.3 V, X5R, 0402 | Murata GRM155R60J475ME47D. Core regulator output (≥ 1 µF at 1.2 V required). | #1-103
Decoupling | 0.1 µF X7R + 1 µF X5R | AVCC_L, AVCC_R, both VCCA pins; 0.1 µF on DVCC and each oscillator VDD

Oscillator enable: pulling pin 1 low puts the output in high impedance. X1 is disabled at ≤ 0.3 × VDD and enabled at ≥ 0.7

DAC Clocking and I2S Interface (ES9038Q2M) · Rev 9 | Page 3 of 5

× VDD or open; X2 is disabled below 0.25 × VDD and enabled at ≥ 0.75 × VDD or open. Both parts share one pinout: 1 OE, 2 GND, 3 OUT, 4 VDD.

Source: ECS-2520MVLC Datasheet (ECS Inc.); (https://www.mouser.com/datasheet/2/122/ECS_2520MVLC-1903379.pdf) ASTX-H11 Datasheet (Abracon); (https://abracon.com/Oscillators/ASTX-H11.pdf) ES9038Q2M Datasheet v1.4 (ESS Technology), (https://www.mouser.sk/datasheet/2/1082/ES9038Q2M_Datasheet_v1_4-3074379.pdf) p. 11 (DVDD capacitor).

### 5. Equations and Results

Internal MCLK (clock gear divider, Register 0)

fMCLK =

fXI
2

clk_gear , clk_gear ∈ {0, 1, 2, 3}

Source: ES9038Q2M Datasheet v1.4 (ESS Technology), (https://www.mouser.sk/datasheet/2/1082/ES9038Q2M_Datasheet_v1_4-3074379.pdf) p. 15. Synchronous mode (DPLL off)

fMCLK = 128 ⋅ fS

Source: ES9038Q2M Datasheet v1.4 (ESS Technology), (https://www.mouser.sk/datasheet/2/1082/ES9038Q2M_Datasheet_v1_4-3074379.pdf) p. 24 (Register 10, 128fs_mode) and p. 52. Master-mode bit clock (Register 10 master_div default)

fBCLK =

fMCLK
2

= 64 ⋅ fS

(two 32-bit slots per frame)

Source: ES9038Q2M Datasheet v1.4 (ESS Technology), (https://www.mouser.sk/datasheet/2/1082/ES9038Q2M_Datasheet_v1_4-3074379.pdf) p. 24. I2C clock limit

fSCL <

fMCLK
20

=

5.6448 MHz
20

= 282 kHz (lowest MCLK)

Source: ES9038Q2M Datasheet v1.4 (ESS Technology), (https://www.mouser.sk/datasheet/2/1082/ES9038Q2M_Datasheet_v1_4-3074379.pdf) p. 14.
Because clk_gear only divides, each oscillator runs at the highest MCLK its family needs:
Oscillator (XI) | clk_gear | fS | MCLK | BCLK
22.5792 MHz | ÷1 / ÷2 / ÷4 | 176.4 / 88.2 / 44.1 kHz | 22.5792 / 11.2896 / 5.6448 MHz | 11.2896 / 5.6448 / 2.8224 MHz
24.576 MHz | ÷1 / ÷2 / ÷4 | 192 / 96 / 48 kHz | 24.576 / 12.288 / 6.144 MHz | 12.288 / 6.144 / 3.072 MHz

Firmware sequence: hold RESETB low, enable one oscillator, wait for it to start (ECS: ≤ 5 ms), release RESETB, then configure the DAC over I2C. To change family: mute or reset the DAC, swap OE lines, wait, resume.

### 6. Important Values

Item | Value
X1 phase noise | −159.8 dBc/Hz at 100 kHz offset (typical plot)
X2 phase noise | −158 dBc/Hz at 100 kHz offset
MCLK range | 5.6448 to 24.576 MHz
DAC Clocking and I2S Interface (ES9038Q2M) · Rev 9 | Page 4 of 5

Item | Value
Maximum fS , synchronous mode | 768 kHz (DAC limit)
I2C address | 0x92 write (ADDR high)
Power-up state | OE lines, RESETB and GPIO1/2 pulled low: oscillators off, DAC in reset

### 7. Open Problems

None.

### 8. Revision Log

Rev | Date | Change
0 | 2026-09-23 | Initial issue: PCM-only interface, pin mapping, clock-source survey, MCLK equations.
1 | 2026-09-23 | Two external oscillators, one per sample-rate family.
2 | 2026-09-23 | XI frequency range recorded.
3 | 2026-09-23 | DAC master, ESP32-S3 slave, DPLL off (synchronous mode).
4 | 2026-09-23 | Oscillator frequencies and clk_gear mapping; I2C speed limit; clock-switching rule.
5 | 2026-09-23 | Oscillators selected: ECS-2520MVLC-225.792-CN-TR, ASTX-H11-24.576MHZ-T.
6 | 2026-09-23 | Pull-downs on both OE lines and RESETB.
7 | 2026-09-23 | RS1/RS2 = 22 Ω at each oscillator output.
8 | 2026-09-25 | Reformatted. Full pin table; GPIO1/GPIO2 functions; RRST = 10 kΩ; ESP32-S3 clock sources and jitter ranking removed; equations typeset.
9 | 2026-09-26 | Maximum sample rate closed at 176.4 / 192 kHz (set by oscillator selection).

### 9. Sources

1. ES9038Q2M Datasheet v1.4 (ESS Technology) (https://www.mouser.sk/datasheet/2/1082/ES9038Q2M_Datasheet_v1_4-3074379.pdf)
2. ECS-2520MVLC Datasheet (ECS Inc.) (https://www.mouser.com/datasheet/2/122/ECS_2520MVLC-1903379.pdf)
3. ASTX-H11 Datasheet (Abracon) (https://abracon.com/Oscillators/ASTX-H11.pdf)
DAC Clocking and I2S Interface (ES9038Q2M) · Rev 9 | Page 5 of 5
