lokeralexander-code/DAP_PCB/Electrical/Documentation/Audio/OPA1622 - Headphone Output/DAP_Output_Stage_OPA1622_Rev4.pdf

# Headphone Output Stage (OPA1622): Working Document

### Digital Audio Player • Rev 4

Author: Alexander Loker. Design decisions, component selection, analysis and verification.
Drafted by: Claude (Anthropic). Structure and prose from the author’s direction and source data.

Contents

1 Summary | 1
2 Design Requirements | 1
3 Pin Configuration | 1
4 External Components | 2
5 Equations and Results | 3
6 Important Values | 4
7 Open Problems | 4
8 Revision Log | 4
9 Sources | 4

### 1. Summary

Field | Value
Amplifier | Texas Instruments OPA1622IDRCR, dual, 10-pin VSON 3 × 3 mm, thermal pad to V−
3.5 mm jack | Same Sky SJ1-3535NS: stereo TRS, right angle, through hole, shielded, tip and ring switches
ESD protection | Texas Instruments ESD122DMXR, 2-channel bidirectional, on tip and ring
Function | Unity-gain headphone driver, one non-inverting follower per channel, with output-inclusive compensation
Signal chain | I/V → differential summing and MFB low-pass → OPA1622 follower → 3.5 mm jack

The summing stage already sets the level (0.85 V peak) and polarity, so the output stage only has to deliver current into the IEM with very low output impedance and stay stable into cable capacitance. A follower keeps polarity, barely loads the MFB filter, and applies the full loop gain as feedback. A small isolation resistor Riso separates the op-amp from cable capacitance; audio-frequency feedback (Rfb) is taken after Riso so the loop removes its effect, and high-frequency feedback (Cf
) is taken before it so the loop does not see the capacitive load.

### 2. Design Requirements

Requirement | Value
Gain | 1
Load | Simgot EW300, 28 Ω ±15% (23.8 Ω worst case): ≈ 36 mA peak per channel at 0.85 V peak
Headphone Output Stage (OPA1622) · Rev 4 | Page 1 of 5

Requirement | Value
Output impedance | < 1 Ω, 20 Hz to 20 kHz
Coupling | DC coupled
Stability | Stable into cable capacitance
DC-fault protection | Firmware monitors the LT3042 and LT3093 power-good outputs and drives EN low on a rail fault. The LT3042 PG goes high impedance in shutdown, so a complete loss of the +3V9 feed is not flagged by that PG.
Filtering | None added. The I/V pole and MFB filter already give ≈ 60 dB at 1 MHz.
Supply | ±3.3 V analog rails
Constraints | Low noise · Small footprint · C0G capacitors in the signal path

### 3. Pin Configuration

### 3.1 OPA1622IDRCR

Pin | Name | Connection
1 | +IN A | SUMM_R
10 | −IN A | Rfb to the ring node; Cf to OUT A
9 | OUT A | Riso to the ring node (RIGHT_EAR)
5 | +IN B | SUMM_L
6 | −IN B | Rfb to the tip node; Cf to OUT B
7 | OUT B | Riso to the tip node (LEFT_EAR)
2 | V+ | +3V3_ANALOG, 0.1 µF + 1 µF to GND
4 | V− | −3V3, 0.1 µF + 1 µF to GND
3 | GND | GND (reference for EN)
8 | EN | Enable divider from the EN_HP GPIO (Section 5)
Pad | Thermal pad | V− (−3.3 V), own pour and via field

Source: OPA1622 Datasheet, SBOS727B (Texas Instruments), (http://www.ti.com/lit/ds/symlink/opa1622.pdf) Section 5 (Pin Functions).

### 3.2 SJ1-3535NS (3.5 mm jack)

Pin | Function | Connection
1 | Sleeve | GND
2 | Tip | Left output (TIP): ESD122 IO2, 10 kΩ bleed to GND
3 | Ring | Right output (RING): ESD122 IO1
4 | Tip switch (closed to tip, opens on insertion) | Detect node: 100 kΩ pull-up to +3V3_DIG, 10 kΩ series to PLUG_DET (GPIO)
5 | Ring switch | Not connected
SH1 to SH3 | Shield | GND

Source: SJ1-353XNS Series Datasheet (Same Sky), (https://sameskydevices.com/product/resource/sj1-353xns.pdf) mechanical drawing and pin table.

### 4. External Components

Ref | Value | Part / Notes | Qty
U | Dual op-amp | TI OPA1622IDRCR, 10-pin VSON | 1
J | 3.5 mm jack | Same Sky SJ1-3535NS | 1
D | 2-channel ESD | TI ESD122DMXR, bidirectional, 0.27 pF, ±3.6 V I/O range | 1
Riso | 4.7 Ω | Op-amp output → jack node | 2
Rfb | 499 Ω, 0.1%, 0402 | YAGEO RT0402BRD07499RL (#1-105). Jack node → −IN. | 2
Cf | 1.5 nF, C0G, 1%, 0603 | Murata GCM1885C1H152FA16D (#1-106). Op-amp output → −IN. | 2
Cdec | 0.1 µF X7R + 1 µF X5R | One pair per supply rail | 4
REN1 | 54.9 kΩ | EN_HP GPIO → EN | 1
REN2 | 50 kΩ | EN → GND; holds EN low at boot | 1
CEN | 0.1 µF X7R | EN → GND; enable ramp | 1
RDET | 100 kΩ | Jack detect node → +3V3_DIG | 1
RSER | 10 kΩ | Detect node → PLUG_DET; limits current if the tip swings negative | 1
RBLEED | 10 kΩ | TIP → GND; defines the tip voltage when the amp is disabled | 1

Plug detect: with no plug, the tip switch ties the detect node to the tip, held near 0 V by the amplifier or RBLEED, so PLUG_DET reads low (≤ 0.3 V). Inserting a plug opens the switch and PLUG_DET reads 3.3 V. The detect node must not share the PLUG_DET net name, or RSER is bypassed.
Tip bleed: the OPA1622 output is not guaranteed high impedance in shutdown, so RBLEED defines the tip voltage for de-tection. It adds 10 kΩ in parallel with a 23.8 Ω IEM (≈ 85 µA at 0.85 V peak, 0.24% of the load current), is linear, and sits inside the feedback loop, so it does not change output impedance or distortion.

Source: OPA1622 Datasheet, SBOS727B (Texas Instruments), (http://www.ti.com/lit/ds/symlink/opa1622.pdf) Section 7.4.1 (Shutdown Mode); ESD122 Product Page and Datasheet (Texas Instruments). (https://www.ti.com/product/ESD122)

### 5. Equations and Results

Feedback handover frequency

fx =

1
2πRfbCf

=

1
2π ⋅ 499 Ω ⋅ 1.5 nF

= 213 kHz

Output impedance

Zout(f) ≈ Riso ∣
Rfb
Rfb + ZCf

∣ , ZCf
=

1
j 2πfCf
Zout(20 kHz) ≈ 4.7 Ω ⋅ 499 |499 − j 5305| = 0.44 Ω

Source: voltage division between Rfb and Cf
in the two-path feedback network; valid while loop gain is high (well below the 8 MHz unity-gain bandwidth).

Enable divider (EN_HP GPIO at 3.3 V)

VEN = 3.3 V ⋅

50 kΩ
54.9 kΩ + 50 kΩ = 1.57 V > VIH,max = 0.95 V

τEN = (54.9 kΩ ∥ 50 kΩ) ⋅ 0.1 μF = 2.6 ms

Source: OPA1622 Datasheet, SBOS727B (Texas Instruments), (http://www.ti.com/lit/ds/symlink/opa1622.pdf) Section 6.5 (Enable pin: VIH 0.82 V typical, 0.95 V maximum over −40 to 125 °C; VIL 0.78 V typical) and Section 7.3.3 (thresholds referenced to the GND pin; EN limited to (V−) − 0.5 V to (V+) + 0.5 V).

Plug-detect level, unplugged and amplifier off

VDET = 3.3 V ⋅

RBLEED

RDET + RBLEED

= 3.3 V ⋅

10 kΩ
110 kΩ = 0.30 V
Quantity (Riso = 4.7 Ω) | Value
Zout at 20 kHz | 0.44 Ω
Extra swing across Riso at 36 mA peak | 0.17 V (op-amp peak ≈ 1.02 V)
Rfb thermal noise, 20 Hz to 20 kHz | 2.9 nV/√Hz, ≈ 0.4 µV RMS

### 5.1 Stability

Datasheet phase margin for a follower (G = +1): ≈ 70° at 200 pF, ≈ 45° at ≈ 430 pF, ≈ 30° at 600 pF, ≈ 0° at 1 nF. Simulation used a 10 mV step with Cload swept at 300 pF, 600 pF and 1 nF.

Load | Network | Overshoot at 300 pF / 600 pF / 1 nF
23.8 Ω ∥ Cload | 2 Ω / 499 Ω / 1.5 nF | Clean at all three
10 kΩ ∥ Cload | Plain follower | Much worse than the compensated network
10 kΩ ∥ Cload | 2 Ω / 499 Ω / 1.5 nF | ≈ 10% / 20% / 40%
10 kΩ ∥ Cload | 4.7 Ω / 499 Ω / 1.5 nF | ≈ 10% / 15 to 20% / 30%, settles in 1 to 2 cycles

The 23.8 Ω IEM load damps cable capacitance. 10 kΩ ∥ 1 nF is a harsh bound (line-out into a long cable), outside the intended use.

Source: OPA1622 Datasheet, SBOS727B (Texas Instruments), (http://www.ti.com/lit/ds/symlink/opa1622.pdf) Figure 24 (Phase Margin vs Capacitive Load).

### 6. Important Values

Item | Value
Output swing from rail | 800 mV (no load), 900 mV (600 Ω): ≈ ±2.4 V on ±3.3 V
Common-mode input range | (V−) + 1.5 V to (V+) − 1 V: −1.8 V to +2.3 V
Gain-bandwidth | 8 MHz at G = 1 (32 MHz at G = 1000)
Quiescent current | 2.6 mA per channel; 5 µA per channel in shutdown
Input voltage noise | 2.8 nV/√Hz at 1 kHz
EN thresholds | High ≥ 0.82 V typ (0.95 V max); low ≤ 0.78 V typ (0.65 V min over temperature)
Jack rating | 1 A, 12 V DC; 5,000 cycles

Source: OPA1622 Datasheet, SBOS727B (Texas Instruments), (http://www.ti.com/lit/ds/symlink/opa1622.pdf) Section 6.5; SJ1-353XNS Series Datasheet (Same Sky). (https://sameskydevices.com/product/resource/sj1-353xns.pdf)

### 7. Open Problems

None.

### 8. Revision Log

Rev | Date | Change
0 | 2026-09-25 | Initial issue: topology, pin connections, component values, EN network, stability data.
1 | 2026-09-25 | Riso placed; plug detect finalized.
2 | 2026-09-25 | Thermal pad, detect net label, output impedance and EN limit resolved.
3 | 2026-09-25 | Reformatted; part numbers clarified; plug-detect section folded into components; EN threshold and tip-bleed sources added; equations typeset.
4 | 2026-09-26 | DC-fault protection set to firmware monitoring of LDO power-good with EN shutdown; open problem closed.

### 9. Sources

1. OPA1622 Datasheet, SBOS727B (Texas Instruments) (http://www.ti.com/lit/ds/symlink/opa1622.pdf)
2. SJ1-353XNS Series Datasheet (Same Sky) (https://sameskydevices.com/product/resource/sj1-353xns.pdf)
3. ESD122 Product Page and Datasheet (Texas Instruments) (https://www.ti.com/product/ESD122)
