lokeralexander-code/DAP_PCB/Electrical/Documentation/Power/LTC3440 - Buck(s)/DAP_LTC3440_Digital_Rev5.pdf

# Digital Buck-Boost (LTC3440): Working Document

### Digital Audio Player • Rev 5

Author: Alexander Loker. Design decisions, component selection, analysis and verification. Drafted by: Claude (Anthropic). Structure and prose from the author’s direction and source data.

Contents

1 Summary | 1
2 Design Requirements | 1
3 Pin Configuration | 1
4 External Components | 2
5 Equations and Results | 2
6 Important Values | 3
7 Open Problems | 3
8 Revision Log | 4
9 Sources | 4

### 1. Summary

Field | Value
Manufacturer / MPN | Analog Devices, LTC3440EMS#TRPBF
Package | 10-lead MSOP (MS)
Function | Synchronous buck-boost, SYS → +3.3 V digital rail

### 2. Design Requirements

Requirement | Value
Input | SYS, 3.0 to 4.2 V
Output | 3.3 V
Load | Digital branch: ESP32-S3, microSD, display logic, DAC digital
Output current | 300 mA max (≈ 253 mA S4 peak)
Switching frequency | 600 kHz (0.48 to 0.72 MHz), separated from the analog LTC3440 (0.96 to 1.44 MHz)
Inductor ripple target | 30%
Mode | Fixed frequency (MODE/SYNC to GND)
Constraints | Low noise · Small footprint

### 3. Pin Configuration

Digital Buck-Boost (LTC3440) · Rev 5 | Page 1 of 4

Pin | Name | Connection
1 | RT | RT to GND
2 | MODE/SYNC | GND (fixed frequency)
3 | SW1 | L
4 | SW2 | L
5 | GND | GND
6 | VOUT | +3V3, COUT, R1
7 | VIN | SYS, CIN
8 | SHDN/SS | VIN (always on, per the typical application)
9 | FB | R1 / R2 midpoint
10 | VC | CP1 and RZ to FB

### 4. External Components

Ref | Value / Rating | MPN | AL-PN
L | 18 µH ±20%; Isat 1.8 / 2.8 / 3.7 A (10 / 20 / 30% drop); Irms 3.3 A; 62.5 mΩ max; shielded, 5.48 × 5.28 × 5.10 mm | Coilcraft XGL5050-183MEC | #1-094
CIN | 4.7 µF 16 V X7R 0805 | Murata GRM21BR71C475KE51L | #1-071
COUT | 22 µF 25 V X7S 1210 | Murata GCM32EC71E226KE36L | #1-073
R1 | 172 kΩ 0.1% 0402 (E192) | TBD
R2 | 100 kΩ 0.1% 0603 | YAGEO RT0603BRD07100KL | #1-066
RT | 100 kΩ 0.1% 0603 | YAGEO RT0603BRD07100KL | #1-066
RZ | 15 kΩ 0.1% 0402 | YAGEO RT0402BRD0715KL | #1-078
CP1 | 1.5 nF ±2% 50 V C0G 0402 | Murata GRM1555C1H152GA01D | #1-077

### 5. Equations and Results

Switching frequency

RT =

6 × 10¹⁰
f

=

6 × 10¹⁰
600 × 10³

= 100 kΩ (0.48 to 0.72 MHz at ± 20%)

Source: LTC3440 Product Page and Datasheet (Analog Devices), (https://www.analog.com/en/products/ltc3440.html) oscillator. Output voltage

VOUT = 1.22 (1 + R1
R2

) ⇒ R1 = 100 kΩ (

3.3

1.22 − 1) = 170.5 kΩ, VOUT = 1.22 (1 + 172
100) = 3.318 V

Source: LTC3440 Product Page and Datasheet (Analog Devices), (https://www.analog.com/en/products/ltc3440.html) output voltage.

Inductor (f in MHz, 300 mA, 30% ripple)

Lboost >

VIN(MIN)

(VOUT − VIN(MIN)

)
f IOUT(MAX) Ripple VOUT

=

3.0 × 0.3
0.6 × 0.3 × 0.3 × 3.3

= 5.05 μH

Lbuck >

VOUT (VIN(MAX) − VOUT)
f IOUT(MAX) Ripple VIN(MAX)

=

3.3 × 0.9
0.6 × 0.3 × 0.3 × 4.2 = 13.1 μH → 18 μH

Source: LTC3440 Product Page and Datasheet (Analog Devices), (https://www.analog.com/en/products/ltc3440.html) inductor selection. Ripple with 18 µH and peak inductor current (3.0 V in, η ≈ 0.85)

Ripplebuck = 30% × 13.1
18

= 21.8% (65 mApp), Rippleboost = 30% × 5.05 18

= 8.4% (25 mApp)

IL,pk =

0.3 × 3.3
3.0 × 0.85

+

0.025
2

= 0.40 A (4.2 V in ∶ 0.33 A)

Copper loss, output capacitance (0.5% ripple) and gate-charge current (f in MHz)

PDCR = I²

LRDCR = 0.388² × 0.0625 = 9.4 mW

COUT ≥

IOUT (VOUT − VIN(MIN)

) ⋅ 100
%Ripple ⋅ V ²

OUT ⋅ f =

0.3 × 0.3 × 100
0.5 × 3.3² × 0.6 × 10⁶

= 2.75 μF (22 μF fitted)

IQ = f (0.75 VIN + 0.25 VOUT) = 0.6 × (0.75 × 4.2 + 0.25 × 3.3) = 2.385 mA

Source: LTC3440 Product Page and Datasheet (Analog Devices). (https://www.analog.com/en/products/ltc3440.html)
Four-switch region and boost right-half-plane zero (3.0 V in, 300 mA, 18 µH)

VIN = VOUT(1 − 150 ns ⋅ f) to

VOUT
1 − 150 ns ⋅ f = 3.00 to 3.63 V

fRHPZ =

V

2
IN
2π IOUT L VOUT

=

3.0²
2π × 0.3 × 18 μH × 3.3

= 80 kHz

Source: LTC3440 Product Page and Datasheet (Analog Devices). (https://www.analog.com/en/products/ltc3440.html)

### 6. Important Values

Item | Value
Switch current limit | 2.7 A typ (2.5 to 2.9 A)
Output | 3.318 V with 172 kΩ
Inductor ripple | 21.8% buck / 8.4% boost with 18 µH
Peak inductor current | 0.40 A at 300 mA, 3.0 V in; well below the 1.8 A 10%-drop point
Inductor at switch limit | 2.9 A max → ≈ 21% inductance drop; fault only, soft saturation
Gate-charge IQ | 2.385 mA at 4.2 V in (≈ 10 mW)
Boost RHP zero | ≈ 80 kHz; loop crossover must stay well below

### 7. Open Problems

None.

### 8. Revision Log

Rev | Date | Change
0 | 2026-09-23 | Initial issue: 600 kHz, 3.3 V / 300 mA, inductor, output capacitance, quiescent current.
1 | 2026-09-23 | MODE/SYNC to GND; R1 172 kΩ.
2 | 2026-09-23 | Inductor Coilcraft XGL5050-183MEC.
3 | 2026-09-23 | Inductor Isat by drop column recorded.
4 | 2026-09-23 | Inductor library part assigned.
5 | 2026-09-25 | Reformatted; linked contents and sources; open problems closed.

### 9. Sources

1. LTC3440 Product Page and Datasheet (Analog Devices) (https://www.analog.com/en/products/ltc3440.html)
