lokeralexander-code/DAP_PCB/Electrical/Documentation/Power/LT3093 - -3V3 LDO/DAP_LT3093_Rev8.pdf

# Negative LDO (LT3093) — Working Document

### Digital Audio Player · Rev 8

Author: Alexander Loker — design decisions, component selection, analysis and verification. Drafted by: Claude (Anthropic) — structure and prose from the author’s direction and source data.

## 1. Part Identification

Field | Value
Manufacturer / MPN | Analog Devices — LT3093EDD#TRPBF (package to confirm)
Package | 12-lead DFN 3 × 3 mm, exposed pad (pin 13) = IN
Function | Ultralow-noise negative LDO, −3V9 → −3.3 V analog rail

## 2. Design Requirements

Requirement | Value
Input | −3V9 from LT3462A inverter (regulated), −3.816 to −3.971 V
Output | −3.32 V
Load | I/V, summing, OPA1622 (V− side), DAC analog TBD
Max output | 0.6 V RMS (EW300: 119 dB/V worst nozzle, 28 Ω ±15%)
Output current ≈ 27 mA quiescent; ≈ 98 mA pk (200 mA rated)
Current limit | 125 mA programmed (R_ILIM)
UVLO | −3.5 V rising
Power good | −3.0 V (90.4% of V_OUT), to MCU GPIO
VIOC | Unused — floated

Constraints: Low noise · Small footprint

## 3. Pin Configuration

Pin | Name | Connection
1, 2 | IN | −3V9, C_IN
3 | EN/UV | R_EN2 from IN, R_EN1 to GND
4 | PG | R_PU to +3V3, MCU GPIO
5 | PGFB | R_PG1 / R_PG2 midpoint
6 | ILIM | R_ILIM to GND (Kelvin to pin 9)
7 | VIOC | No connect (float)
8 | SET | R_SET ∥ C_SET to GND — C_SET cathode to SET (SET is
| | −3.32 V)
9 | GND | GND
10 | OUTS | OUT at load
11, 12 | OUT | −3V3A, C_OUT, R_PG1
13 | Exposed pad | IN (−3V9) — own pour and via field, never GND

## 4. External Components

Ref | Value | Rating /
| | package | MPN | AL-PN
R_SET | 33.2 kΩ 0.1% | 0402 | YAGEO RT0402BRD0733K2L | #1-085
C_SET | 2.2 µF ±20%
| tantalum (no
| DC-bias derating,
| not piezoelectric) | 16 V MnO2
| | 0603, polarized
| | — anode to
| | GND | Vishay 298D225X0016M2T | #1-098
C_IN | 10 µF (6.76 µF
| eff. at 3.9 V) | 10 V X7R 0805 | Murata GCM21BR71A106KE22K | #1-081
C_OUT | 10 µF (7.56 µF
| eff. at 3.3 V) | 10 V X7R 0805 | Murata GCM21BR71A106KE22K | #1-081
R_EN1 | 50 kΩ 0.1% | 0603 | YAGEO RT0603BRD0750KL | #1-075
R_EN2 | 88.7 kΩ 0.1% | 0402 | YAGEO RT0402BRD0788K7L | —
R_PG1 | 135 kΩ 0.1%
| (E192) | 0402 | YAGEO RT0402BRD07135KL | —
R_PG2 | 15 kΩ 0.1% | 0402 | YAGEO RT0402BRD0715KL | #1-078
R_ILIM | 15.6 kΩ 0.1%
| (E192) | 0402 | YAGEO RT0402BRD0715K6L | —
R_PU | 10 kΩ | 0603 | Generic | —

## 5. Equations and Results

Output voltage (range over I_SET 98 – 102 µA)

### VOUT = −ISET RSET = −100 μA × 33.2 kΩ = −3.32 V (−3.254 to − 3.386 V )

Undervoltage lockout (IEN term neglected — ignorable for REN1 < 100 kΩ)

VIN(UV LO) = −1.26 (1 + REN2
| | | REN1) − IENREN2

REN2 = REN1 (

3.5

### 1.26 − 1) = 50 kΩ × 1.778 = 88.89 kΩ → 88.7 kΩ

### VIN(UV LO) = −1.26 (1 + 88.7 50 ) = −3.495 V (−3.33 to − 3.69 V )

VIN(UV LO, falling) = −(1.26 − 0.215) (1 + 88.7

### 50 ) = −2.90 V (sim: ≈ −3.0 V )

Power good threshold (IPGFB term neglected — ignorable for RPG2 < 30 kΩ; R_PG1 is the top resistor)

VOUT (PG) = −0.3 (1 + RPG1 RPG2) − IPGFBRPG1

RPG1 = RPG2 (

3.0

### 0.3 − 1) = 15 kΩ × 9 = 135 kΩ

### VOUT (PG) = −0.3 (1 + 135 15 ) = −3.000 V (90.4%) (−2.88 to − 3.12 V )

Current limit (ILIM regulates to −300 mV; 1.95 kΩ·A scale factor)

ILIM =

### 1.95 kΩ ⋅ A

RILIM

=

### 1.95 kΩ ⋅ A 15.6 kΩ = 125 mA (1.27 × the 98 mA peak)

SET noise filter corner (1 µF effective)

fc =

1

2πRSETCSET

=

1

### 2π × 33.2 kΩ × 1 μF = 4.8 Hz

Soft-start (fast start-up to PG threshold −3.0 V, then R_SET·C_SET tail)

τ = RSETCSET , t99 − tPG = τ ln

0.32
0.033

### = 2.27 τ ≈ 75 ms/μF (2.2 μF ∶ 166 ms)

Maximum SPL (0.6 V RMS, EW300 copper nozzle 119 dB/V)

### SP LMAX = 119 + 20 log10(0.6) = 114.6 dB (116.6 dB steel nozzle)

Headroom (regulated input, low tolerance; datasheet max dropout 280 mV at 100 mA)

### |VIN(MIN)| − |VOUT (MIN)| − VDO(MAX) = 3.816 − 3.287 − 0.28 = 0.25 V margin

Dissipation (98 mA pk, IGND ≈ 4 mA)

### PD = 0.098 × (3.981 − 3.32) + 0.004 × 3.981 ≈ 0.08 W, ΔTJ ≈ 0.08 × 34 ≈ 2.8 ∘C

Load current (0.6 V RMS = 0.85 V pk design maximum, both channels in phase)

Case | Per channel pk | Signal total | + Quiescent | LT3093 pk
Full scale, 23.8 Ω (28 Ω −15%) | 35.7 mA | 71.3 mA | 27 mA | ≈ 98 mA
Full scale, 28 Ω nominal | 30.3 mA | 60.6 mA | 27 mA | ≈ 88 mA
110 dB SPL peak (0.35 V RMS), 23.8 Ω | 21.1 mA | 42.2 mA | 27 mA | ≈ 69 mA

Dropout sweep (sim, ideal source; V_OUT 1% low = −3.287 V)

Load | V_IN at dropout Dropout
29 Ω (≈ 115 mA) | −3.490 V | 203 mV
16.5 Ω (≈ 201 mA) −3.501 V | 214 mV

C_SET sweep (sim, ideal −3.9 V source, 29 Ω load; model reads ≈ 0.70 µV vs datasheet 0.8 µV at 4.7 µF, 10 Hz – 100 kHz)

C_SET (effective) t_99 after PG | Noise, 20 Hz – 20 kHz
0.47 µF | ≈ 35 ms | 1.44 µV RMS
1 µF | ≈ 75 ms | 0.75 µV RMS
2.2 µF | 166 ms (sim) 0.44 µV RMS
4.7 µF | ≈ 355 ms | 0.34 µV RMS

Output impedance (sim, 29 Ω DC load)

Frequency | Z_OUT
1 kHz | 0.26 mΩ
20 kHz | 5.2 mΩ
282 kHz (peak) 76 mΩ

Startup and brownout (sim, 2.2 µF C_SET)

Event

Rising (0 → −3.9 V in 20
ms)

Falling (−3.9 → 0 V in 50
ms)
Output starts / loses regulation | V_IN = −3.62 V (≈ 0.6 ms after EN trip) | V_IN = −3.490 V
PG changes | V_OUT = −3.000 V, 3.9 ms after start | V_IN = −3.129 V
Settled 99% / shut down | 166 ms after PG | V_IN = −2.957 V

Load step (sim, 27 ↔ 205 mA, 1 µs edges — conservative vs 98 mA max; identical at −3.9 V and −3.74 V input)

Item | Value
Peak deviation | −7.6 mV / +3.6 mV around −3.320 V
Ringing | Damped, ≈ 2 cycles at ≈ 140 kHz
Settling (±0.3 mV) | ≈ 20 µs
DC shift 27 → 205 mA | Not visible (< 0.1 mV)

Line transient and input ripple (sim, 205 mA load)

Item | Value
Line step −3.9 → −3.74 V (1 µs edge) | 61 µV peak, settles ≈ 20 µs (≈ 68 dB)
Line regulation, 160 mV step | ≈ 2 µV DC shift
Input ripple 7.7 mV pp at 1.2 MHz | 1.67 µV pp at OUT (PSRR predicts 0.98
| µV)

## 6. Important Values

Item | Value
SET pin current | 100 µA (98 – 102 µA over temp)
EN/UV negative threshold | −1.26 V (−1.20 to −1.33 V), 215 mV hysteresis
PGFB threshold | −300 mV (288 – 312 mV), 7 mV hysteresis
Dropout | 214 mV sim / 330 mV max at 200 mA
Peak load | ≈ 98 mA at 0.6 V RMS max (49% of rating)
Input headroom margin | 0.25 V at worst-case input tolerance and max dropout
Rated output current | 200 mA
Current limit | 125 mA programmed; internal backup 400 mA typ, 220 mA min
GND pin current | 2.35 mA quiescent; ≈ 7 mA at 200 mA (in dropout)
Shutdown current | 3 µA typ
UVLO divider current | ≈ 28 µA from −3V9
PG divider current | ≈ 22 µA from OUT
Output noise | 0.44 µV RMS at 2.2 µF, 20 Hz – 20 kHz (sim; model ≈ 15%
| optimistic)
PSRR | −77.9 dB at 1.2 MHz, both −3.9 V and −3.74 V input (sim)
Output impedance | 5.2 mΩ at 20 kHz; 76 mΩ peak at 282 kHz (sim)
Load step 27 ↔ 205 mA | −7.6 / +3.6 mV, settles in ≈ 20 µs; no dropout at −3.74 V (sim)
Line step / ripple | 61 µV for 160 mV step; 1.67 µV pp from 7.7 mV pp at 1.2 MHz (sim)
Fast start-up | 0 → −3.0 V in 3.9 ms
Firmware delay | Wait ≥ 170 ms after PG before OPA1622 enable (2.2 µF)
C_SET leakage | 0.5 µA max at 16 V rating → ≤ 0.5% output error; far lower at 3.3 V
PG at cold start | Reads high until IN passes ≈ −1.8 V — ignore PG until +3V3 is up
Brownout order | Dropout (−3.49 V) → PG low (−3.13 V) → off (−2.96 V)
C_OUT requirement | ≥ 4.7 µF, ESR < 30 mΩ, ESL < 1.5 nH
θJA (DFN) | 34 °C/W
PG in shutdown | Pulled low — reads not-good (opposite of LT3042)
VIOC | Floated; ≈ 120 kΩ internal to GND

# | Problem

## 7. Open Problems

# | Problem

1 | Exposed pad is IN (−3V9) — dedicated pour and via field; footprint must not tie to
| GND
2 | Quiescent (27 mA) unconfirmed — I/V estimate, OPA1622 I_Q at ±3.3 V unread
3 | DAC analog supply allocation to this rail open
4 | Confirm package (DFN vs MSOP-12E) and R_EN2 / R_PG1 MPNs
5 | PG brownout warning is 2.2 ms at sim ramp rate — real brownout faster; consider
| hardware mute from PG
6 | PG low specified at 100 µA; 10 kΩ to +3V3 sinks 330 µA — verify or raise R_PU
7 | ILIM scale-factor tolerance — confirm minimum limit stays above 98 mA; confirm
| R_ILIM MPN
8 | PSRR at 2.7 MHz (2.0 – 3.5 MHz) — read from the existing AC sim
9 | Sims remaining: current limit at 125 mA, PG in shutdown, full chain with LT3462A

## 8. Revision Log

Rev | Date | Change
0 | 2026-09-22 Initial issue: R_SET, UVLO, PG, soft-start, headroom, dissipation, open
| | problems.
1 | 2026-09-22 PG divider to 135 kΩ / 15 kΩ, threshold −3.0 V; R_PG2 reuses #1-078.
2 | 2026-09-22 Sim results added: dropout, PSRR, noise sweep, Z_OUT, startup,
| | brownout. C_SET 2.2 µF 25 V. Closed: noise validation, startup knee, UVLO falling behaviour, firmware delay.
3 | 2026-09-22 Load step result added; closed from remaining sims.
4 | 2026-09-22 Line transient and 1.2 MHz ripple results added.
5 | 2026-09-22 Max output set to 0.6 V RMS (EW300); peak load 205 → 98 mA. Closed:
| | 200 mA rating exceeded, LTC3440 250 mA overload.
6 | 2026-09-22 Current limit programmed to 125 mA: R_ILIM 15.6 kΩ.
7 | 2026-09-23 Input from LT3462A inverter (regulated −3.909 V). Closed: pump
| | selection, UVLO margin to the −3.74 V dip.
8 | 2026-09-23 C_SET to 2.2 µF tantalum 298D225X0016M2T (#1-098), cathode to SET.
| | Closed: C_SET MPN and piezo concern.
