lokeralexander-code/DAP_PCB/Electrical/Documentation/Power/BQ24250 - Charger/BQ-CHARGER-V1.png

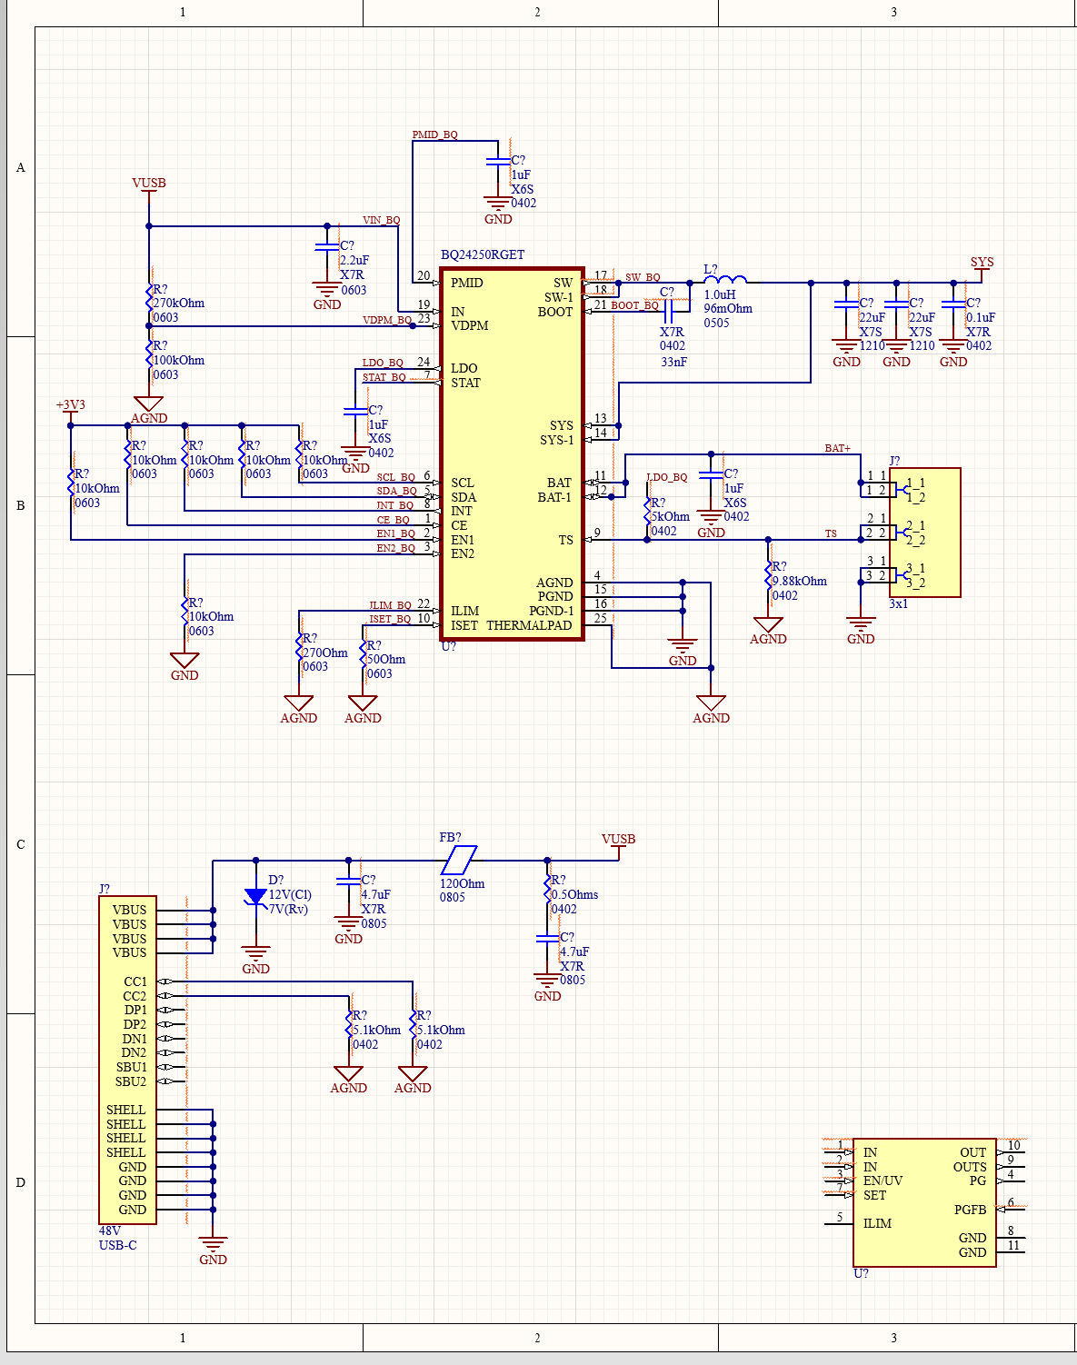
Electrical/Documentation/Power/BQ24250 - Charger/BQ-CHARGER-V1.png
