lokeralexander-code/DAP_PCB/Electrical/Simulations/Op-Amp_Sims/PROJECT1.png

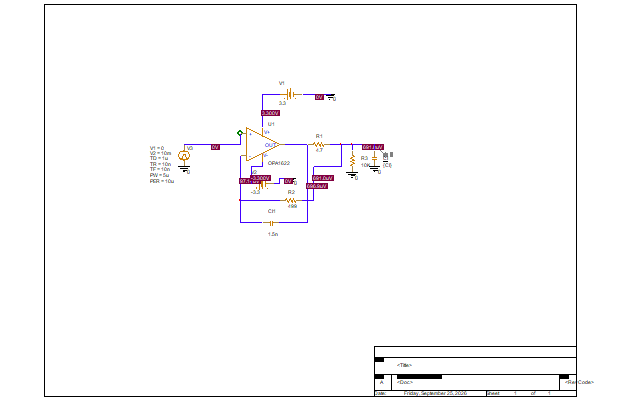
Electrical/Simulations/Op-Amp_Sims/PROJECT1.png
