lokeralexander-code/DAP_PCB/Electrical/Simulations/Op-Amp_Sims/PROJECT2.png

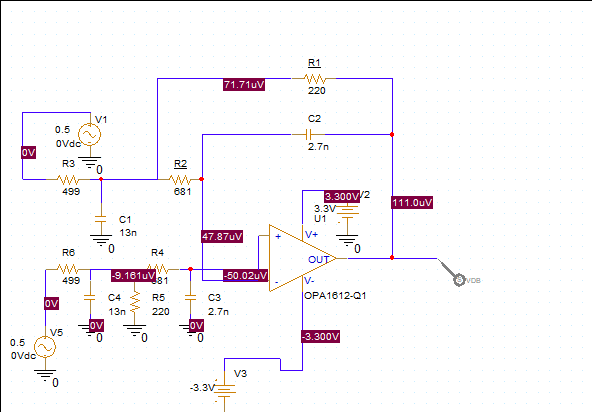
Electrical/Simulations/Op-Amp_Sims/PROJECT2.png
