lokeralexander-code/DAP_PCB/Electrical/Simulations/Op-Amp_Sims/Project2-PSpiceFiles/SCHEMATIC1/AC_ANALYSIS/AC_ANALYSIS.cir

** Profile: "SCHEMATIC1-AC_ANALYSIS"  [ C:\Users\loker\Projects\DAP_PCB\Electrical\Op-Amp_Sims\Project2-PSpiceFiles\SCHEMATIC1\AC_ANALYSIS.sim ] 

** Creating circuit file "AC_ANALYSIS.cir" 
** WARNING: THIS AUTOMATICALLY GENERATED FILE MAY BE OVERWRITTEN BY SUBSEQUENT SIMULATIONS

*Libraries: 
* Profile Libraries :
* Local Libraries :
* From [PSPICE NETLIST] section of C:\cds_spb_home\cdssetup\OrCAD_PSpiceTIPSpice_Install\23.1.0\PSpice.ini file:
.lib "nom_pspti.lib" 
.lib "nom.lib" 

*Analysis directives: 
.AC DEC 100 10 10Meg
.OPTIONS ADVCONV
.OPTIONS FILEMODELSEARCH
.PROBE64 V(alias(*)) I(alias(*)) W(alias(*)) D(alias(*)) NOISE(alias(*)) 
.INC "..\SCHEMATIC1.net" 


.END
