lokeralexander-code/DAP_PCB/Electrical/Simulations/Charger_Sims/USB-filter.asc

C1: cap; 4.7µ; V=16 Irms=0 Rser=.01 Lser=.0003u
C2: cap; 4.7µ; V=16 Irms=0 Rser=.01 Lser=.0003u
C3: cap; 2.2µ; V=16 Irms=0 Rser=.01 Lser=.0003u
I1: current; 0; AC 1
L1: ind; {Lcab}; Rser=1m
L2: FerriteBead; 377n; Ipk=3 Rser=0.027 Rpar=177 Cpar=847f mfg="Würth Elektronik" pn="742792023 WE-CBF 0805"
R1: res; 0.5
Rcable: res; {Rcab}
V1: voltage; 5; AC 0 0; Rser=50m
Named nets: 0, Load, OUT
.ac dec 100 1k 100Meg
.inc GCM188R71H104KA57_DC5V_25degC.mod
.step param n list 1 2 3
.param Rcab = table(n, 1, 0.033, 2, 0.17, 3, 0.4)
.param Lcab = table(n, 1, 250n, 2, 500n, 3, 1u)
.plot ac V(OUT)
