lokeralexander-code/DAP_PCB/Electrical/Simulations/Buck_Boost_Digital_Sims/3V3_Buck_Boost.asc

C1: cap; 10µ; V=16 Irms=0 Rser=0 Lser=0 mfg="Murata" pn="GRM21BZ71C106ME15" type="X7R"
C2: cap; 0.0015µ; V=50 Irms=0 Rser=0 Lser=0 mfg="Murata" pn="GCM155R71H152JA37" type="X7R"
C3: cap; 22µ; V=10 Irms=0 Rser=0.002 Lser=0.001n
C4: cap; 100p; V=50 Irms=0 Rser=0.0708 Lser=373p mfg="Würth Elektronik" pn="885012005061 WCAP-CSGP 0402" type="NP0"
C5: cap; 0.1µ; V=16 Irms=4.39 Rser=0.0357547 Lser=0 mfg="KEMET" pn="C0402C104K4RAC" type="X7R"
C6: cap; 22µ; V=10 Irms=0 Rser=0.002 Lser=0.001n
C7: cap; 22µ; V=10 Irms=0 Rser=0.002 Lser=0.001n
I1: current; PULSE(30m 300m 11.2m 1u 1u 0.4 0.8)
L1: ind; 18µ; Ipk=3.7 Rser=62.5m
R2: res; 100K
R3: res; 100K
R4: res; 172K
R5: res; 50K
R6: res; 54.9K
U1: LTC3440
V1: voltage; {Vs}
Named nets: 0, in, out, sw1, sw2
.step param Vs list 3.0 4.2
.tran 0 12m 11m
.meas TRAN vmax MAX V(out)
.meas TRAN vmin MIN V(out)
