lokeralexander-code/DAP_PCB/Electrical/Simulations/Inverting_Sims/Inverting_Regulator.asc

C1: cap; 1µ; V=25 Irms=0 Rser=0 Lser=0 mfg="Murata" pn="GCM188R71E105MA64" type="X7R"
C2: cap; {Cff}; V=25 Irms=0 Rser=0 Lser=0
C3: cap; 10µ; V=16 Irms=0 Rser=0 Lser=0 mfg="Murata" pn="GCM31CR71C106MA64" type="X7R"
C5: cap; 10µ; V=16 Irms=0 Rser=0 Lser=0 mfg="Murata" pn="GCM31CR71C106MA64" type="X7R"
I1: current; PULSE(0 71m 4.2m 1u 1u 0.4m 0.8m)
L1: ind; 22µH; Ipk=0.4 Rser=0.81
L2: ind; 22µH; Ipk=0.4 Rser=0.81
R1: res; 309K
R2: res; 100K
R3: res; 144.8
U1: LT3462A
V1: voltage; 3.9
Named nets: 0, out, in, sw, d, fb
.tran 0 5m 4m
.step param Cff list 18p 22p
.meas TRAN vmax MAX V(out)
.meas TRAN vmin MIN V(out)
