lokeralexander-code/DAP_PCB/Electrical/Simulations/Buck_Boost_Sims_Plus_LDO/LDO_3V3_NEGATIVE.asc

C1: cap; 7.559µ
C2: cap; 6.5µ
cset1: cap; 2.2µ; V=25 Irms=0 Rser=0 Lser=0
I1: current; 205m
R2: res; 33.2K
R3: res; 50K
R4: res; 88.7K
R11: res; 135K
R13: res; 15K
R14: res; 10K
U1: LT3093
V4: voltage; 3.3
Vin: voltage; SINE(-3.9 3.85m 1.2Meg)
Named nets: 0, pg, out, in
.tran 0 2m 0m 20n
.options plotwinsize=0
.meas TRAN vpp PP V(out) FROM 1.5m TO 2m
