lokeralexander-code/DAP_PCB/Electrical/Simulations/Buck_Boost_Sims_Plus_LDO/Buck-Boost_LDO_3V3.asc

C4: cap; 6.759µ; Rser=0.004
C5: cap; 7.559µ
cset: cap; {cset}
R5: res; 33.2K
R6: res; 90.9K
R7: res; 50K
R8: res; 909K
R9: res; 100K
R10: res; 10K
R12: res; 29
U2: LT3042
V1: voltage; 3.9; AC 1
V2: voltage; 3.3
Named nets: 0, pg, ldo_in, out
.step param cset list 0.47u 1u 2.2u 4.7u
.noise V(out) V1 dec 50 10 1Meg
.meas NOISE vn INTEG V(onoise) FROM 20 TO 20k
