lokeralexander-code/DAP_PCB/Electrical/Simulations/Buck_Boost_Sims_Plus_LDO/Buck-Boost.asc

C1: cap; 22µ; V=16 Irms=0 Rser=0.003 Lser=0
C2: cap; 4.7µ; V=16 Irms=0 Rser=0 Lser=0 mfg="Murata" pn="GRM188Z71C475KE21" type="X7R"
C3: cap; 0.0015µ; V=50 Irms=0 Rser=0 Lser=0 mfg="Murata" pn="GCM155R71H152JA37" type="X7R"
I1: current; PULSE(.15 .25 1m 1u 1u 1m 2m)
L1: ind; 5.44µ; Rser=74.1m Cpar=5.5p
R1: res; 220K
R2: res; 100K
R3: res; 50K
R4: res; 15K
U1: LTC3440
V1: voltage; PULSE(0 3.3 0 1n 1n 1 2)
vin: voltage; 3; Rser=0.21
Named nets: 0, out
.tran 0 3m 0m 10n
.meas TRAN vpp PP V(out)
.meas TRAN vavg AVG V(out)
.meas TRAN vrip PP V(out) FROM 2m TO 2.99m
.options plotwinsize=0 method=gear
