lokeralexander-code/DAP_PCB/Electrical/Simulations/Charger_Sims/Draft1.asc

I1: current; 0.64
L1: ind; 1µ; Ipk=2 Rser=96m
V1: voltage; PULSE(0 5 0 2n 2n 200n 333n)
X1: cap; GRM32ER71E226KE15_DC4V33_25degC
X2: cap; GRM32ER71E226KE15_DC4V33_25degC
X3: cap; GRM32ER71E226KE15_DC4V33_25degC
Named nets: 0, SYS
.tran 0 20u 15u 1n
.meas TRAN vpp PP V(sys)
