lokeralexander-code/DAP_PCB/Electrical/Simulations/Charger_Sims/SYS-output.asc

C1: cap; 0.1µ; V=25 Irms=0 Rser=0 Lser=0 mfg="Murata" pn="GCM155R71E104KE02" type="X7R"
I1: current; PULSE(0.18 0.6 150u 1u 1u 40u 200u)
L1: ind; 1µ; Ipk=2 Rser=96m
V1: voltage; PULSE(0 5 0 2n 2n 200n 333n)
X1: cap; GRM32ER71E226KE15_DC4V33_25degC
X2: cap; GRM32ER71E226KE15_DC4V33_25degC
Named nets: 0, SYS
.tran 0 250u 100u 1n
.meas TRAN vpp PP V(sys)
.inc GRM32ER71E226KE15_DC4V33_25degC.mod
.meas TRAN vbase AVG V(sys) FROM 145u TO 149u
.meas TRAN vmin  MIN V(sys) FROM 150u TO 156u
.meas TRAN droop PARAM vbase-vmin
