lokeralexander-code/DAP_PCB/(list of files, drawings)

Other design files:
Electrical/PCB_Project/Copy of DAP-Peripherals-4.SchDoc
Electrical/PCB_Project/DAP-Audio-1.SchDoc
Electrical/PCB_Project/DAP-MCU-3.SchDoc
Electrical/PCB_Project/DAP-PCB-REV-1.PcbDoc
Electrical/PCB_Project/DAP-PCB-REV-2.PcbDoc
Electrical/PCB_Project/DAP-PCB-REV-3.2.PcbDoc
Electrical/PCB_Project/DAP-PCB-REV-3.PcbDoc
Electrical/PCB_Project/DAP-PCB-REV-4.PcbDoc
Electrical/PCB_Project/DAP-PCB.PcbDoc
Electrical/PCB_Project/DAP-Peripherals-4.SchDoc
Electrical/PCB_Project/DAP-Power-2.SchDoc
Electrical/PCB_Project/DAP.PrjPcb
Electrical/PCB_Project/PCB_Project.PrjPcb
Electrical/Simulations/Op-Amp_Sims/PROJECT1.DSN
Electrical/Simulations/Op-Amp_Sims/Project1.opj
Electrical/Simulations/Op-Amp_Sims/PROJECT2.DSN
Electrical/Simulations/Op-Amp_Sims/Project2.opj
