lokeralexander-code/DAP_PCB/(commit log)

2026-09-16 Initial project documentation, using Claude to document my thoughts, discuss and bounce off ideas for the project, as well as research what ICs to look for, and how I should begin making this DAP. Co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
    [DAP-Power-2.SchDoc, DAP.PrjPcb]
2026-09-17 Begun charger IC, need to add filtering, and add USB-C
    [DAP-Power-2.SchDoc, DAP.PrjPcb]
2026-09-19 USB C Input filter, BQ Charger IC output filter simulated in LTspice, rev 0 of BQ Charger IC documentation, first version of DAP-Power-2.schdoc aswell.
    [DAP-Power-2.SchDoc]
2026-09-21 Updated Charger, more work on buck-boost including start of simulating. Dealing with odd output voltage problem above 150mA simulated output current.
    [DAP-Power-2.SchDoc]
2026-09-22 Buck boost simulation and schematic v1 complete, revised documents for readability and condense-ness and added .gitignore for file storage
    [DAP-Power-2.SchDoc]
2026-09-22 Simulated and did schematic for the positive 3.3V LDO
    [DAP-Power-2.SchDoc]
2026-09-22 Started negative 3.3V LDO, finished USB-C with diff pair schematic addition.
    [DAP-Power-2.SchDoc]
2026-09-22 -3V3 DAP schematic complete alongside simulations to confirm
    [DAP-Power-2.SchDoc]
2026-09-23 updated documents and Altium to reflect a design change of max VRms lowering from 1V -> 0.6V, as 1V was unnecessarily high given the IEM's used are not extremely insensitive. This drops current draw 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
    [DAP-Power-2.SchDoc]
2026-09-23 Added inverted regulator
    [DAP-Power-2.SchDoc]
2026-09-23 Added documentation files, including documentation for 3.3V buck converter for digital components I am beginning to simulate
2026-09-23 Added 3.3V Buck boost for digital architecture, power v1 done!
    [DAP-Power-2.SchDoc]
2026-09-23 Added schs and ICs into schs, starting revision of power and then DAC schematic
    [DAP-MCU-3.SchDoc, DAP-Peripherals.SchDoc, DAP-Power-2.SchDoc, DAP.PrjPcb]
2026-09-23 REvised power document to add ESD protection, replaces SET caps on LDOS with tantulum due to pizoelectric mechanical noise
    [DAP-Power-2.SchDoc]
2026-09-23 Finished DAC Rev 1 schematic alongside documentation!
    [DAP-MCU-3.SchDoc, DAP-PCB.PcbDoc, DAP-Power-2.SchDoc, DAP.PrjPcb]
2026-09-25 Summing stage done, alongside simulation, moving to final op-amp output, documentation incl.
    [PROJECT2.DSN, Project2.opj]
2026-09-25 Added opa1622 to schematic, did basic routing, ALSO! Just realized the audio schem wasnt in the right folder. Wow. Fixed now
    [DAP-Audio-1.SchDoc]
2026-09-25 Finished audio schematic and document
    [DAP-Audio-1.SchDoc, DAP.PrjPcb, PROJECT1.DSN, Project1.opj]
2026-09-25 Restructured and revised the documentation significantly for readability and accuracy
    [PROJECT1.DSN, PROJECT2.DSN, Project1.opj, Project2.opj]
2026-09-27 Started ESP-32 Schematic
    [DAP-Audio-1.SchDoc, DAP-MCU-3.SchDoc, DAP-Power-2.SchDoc]
2026-09-27 Started on peripherals, cleaned up some schematics, attached many GPIOs on the MCU For the ESP-32-S3. Documented peripherals aswell.
    [DAP-Audio-1.SchDoc, DAP-MCU-3.SchDoc, DAP-PCB.PcbDoc, DAP-Peripherals.SchDoc, DAP-Power-2.SchDoc, DAP.PrjPcb]
2026-09-29 Finished entire schematic, including LCD Screen implementation and GPIO distribution and power on MCU. Need to review now
    [DAP-MCU-3.SchDoc, DAP-Peripherals.SchDoc, DAP-Power-2.SchDoc]
2026-09-29 Renamed peripherals file
    [DAP-Peripherals-4.SchDoc, DAP-Peripherals.SchDoc, DAP.PrjPcb]
2026-09-29 More revisions + documents
    [DAP-Audio-1.SchDoc, DAP-MCU-3.SchDoc, DAP-Peripherals-4.SchDoc, DAP-Power-2.SchDoc, DAP.PrjPcb]
2026-09-30 Implemented proper MCU filters according to datasheet, aswell as rearranging GPIOs. Need to do a lot of confirmation work on proper GPIO placement, aswell as add Encoder, FLASH, and SD card. Not done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
    [DAP-MCU-3.SchDoc, DAP-Power-2.SchDoc]
2026-09-30 Added flash
    [DAP-MCU-3.SchDoc]
2026-10-01 Added encoder, ESD diodes, SD card, and added documentation. Almost done rev1 of total schematic.
    [DAP-MCU-3.SchDoc, DAP-Peripherals-4.SchDoc]
2026-10-02 Replaced all 100K and 10K ohm with 0402 counterparts, added an LED driver to accomodate for no 5V source on my board without creating a whole new buck, replaced all lower-end 0402 1 uF with proper 06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
    [DAP-Audio-1.SchDoc, DAP-MCU-3.SchDoc, DAP-Peripherals-4.SchDoc, DAP-Power-2.SchDoc]
2026-10-02 Done schematic version 2, named components and organized to be more readable.
    [Copy of DAP-Peripherals-4.SchDoc, DAP-Audio-1.SchDoc, DAP-MCU-3.SchDoc, DAP-PCB.PcbDoc, DAP-Peripherals-4.SchDoc, DAP-Power-2.SchDoc, DAP.PrjPcb]
2026-10-02 Schematic done, documentation done, may revise more in the future, but the layout begins!
    [DAP-Audio-1.SchDoc, DAP-PCB.PcbDoc, DAP-Power-2.SchDoc, DAP.PrjPcb]
2026-10-03 Update README with PCB progress
    Added PCB progress update to README.
2026-10-03 Added basic footprint layout for both +3V3 LDO, 3.9V Buck-boost, and Bq Charger IC
    [DAP-Audio-1.SchDoc, DAP-PCB.PcbDoc, DAP-Peripherals-4.SchDoc, DAP-Power-2.SchDoc]
2026-10-04 removed interface butttons, restructuring UI/UX due to size constraints, finished IC component placement for power and audio, made some other light schematic changes aswell.
    [DAP-Audio-1.SchDoc, DAP-PCB.PcbDoc, DAP-Peripherals-4.SchDoc]
2026-10-05 Even more component placement + encoder change
    [DAP-MCU-3.SchDoc, DAP-PCB.PcbDoc, DAP-Peripherals-4.SchDoc]
2026-10-05 Changed battery port for a smaller header, component placement complete! (Will need lots of revisions). Updated docs.
    [DAP-PCB.PcbDoc, DAP-Peripherals-4.SchDoc, DAP-Power-2.SchDoc]
2026-10-05 MORE PLACEMENT AND ROUTING!
    [DAP-Audio-1.SchDoc, DAP-PCB.PcbDoc, DAP-Peripherals-4.SchDoc, DAP-Power-2.SchDoc]
2026-10-06 MORE ROUTING AND MORE ROUTING
    [DAP-Audio-1.SchDoc, DAP-PCB.PcbDoc]
2026-10-06 More routing
    [DAP-MCU-3.SchDoc, DAP-PCB.PcbDoc, DAP-Power-2.SchDoc]
2026-10-06 routing and placement v1 done, pcb done v1, doesn't feel great though. will need revising.
    [DAP-PCB.PcbDoc, DAP-Peripherals-4.SchDoc, DAP-Power-2.SchDoc, DAP.PrjPcb]
2026-10-07 new board, placements done
    [Copy of DAP-PCB.PcbDoc, DAP-Audio-1.SchDoc, DAP-PCB.PcbDoc, DAP-Power-2.SchDoc]
2026-10-07 Basic placement done on rev2
    [DAP-PCB.PcbDoc]
2026-10-07 Rev 2 layout, needs slight revisions but MUCH better.
    [DAP-Audio-1.SchDoc, DAP-MCU-3.SchDoc, DAP-PCB.PcbDoc, DAP-Peripherals-4.SchDoc, DAP-Power-2.SchDoc]
2026-10-08 More refinin
    [DAP-PCB.PcbDoc]
2026-10-08 Added LEDs, silk, and a couple other small changes including crosstalk reduction
    [DAP-Audio-1.SchDoc, DAP-PCB.PcbDoc, DAP-Power-2.SchDoc]
2026-10-09 Rev 2 done, but I need serious improvements
    [DAP-Audio-1.SchDoc, DAP-PCB-REV-1.PcbDoc, DAP-PCB-REV-2.PcbDoc, DAP-PCB.PcbDoc, DAP-Peripherals-4.SchDoc]
2026-10-09 Took 4 hours but basic placement and routing done for rev 3. Looking much better.
    [DAP-PCB.PcbDoc, DAP-Peripherals-4.SchDoc]
2026-10-09 nearly done! Just need to do the encoder routing and small touchups until review cycle begins
    [DAP-MCU-3.SchDoc, DAP-PCB.PcbDoc]
2026-10-10 Revision and DRC time
    [DAP-MCU-3.SchDoc, DAP-PCB.PcbDoc]
2026-10-10 PCB Complete! Onto external revisions and documentation
    [DAP-PCB.PcbDoc]
2026-10-11 Done the PCB! Waiting for reviews
2026-10-11 Small schematic changes
2026-10-13 Added ESD protection to buttons
2026-10-16 removed potential ground antennas
2026-10-17 Changed some documentation, reviewed board further, imrpoved ESD routing, shortened GNDs on analog signals, more coutouts too.
2026-10-26 Verified all footprints, some parts may be subject to change due to complications in potential manufacturing
2026-10-27 Replaced ESP32 and DAC Caps with one size smaller, introducing 0201's. Rerouting and replacing right now, contemplating a full reroute.
2026-10-28 Changed SD Card routing for ESP32-S3 hardware specifications, changed ALL MCU routing for a direct path to the USB-high-speed diff pair, did corrections and all rule checks. Decided to go with rev 3.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
2026-11-10 doing schematic review
